ra3xdh/TRX_RA3XDH_v2/README.md

## Описание

Схема и печатная плата для улучшенной версии моего трансивера из журнала Радио №2, 2009.

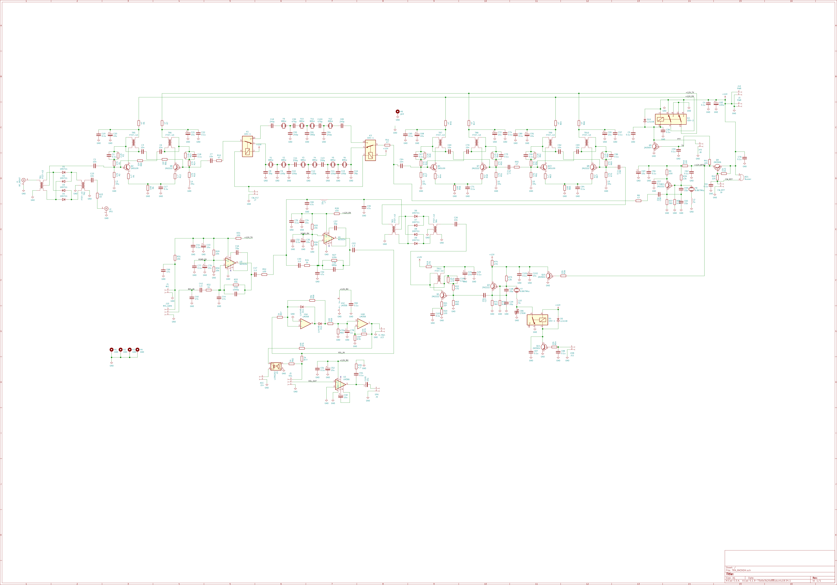
[picture p1: TRX_RA3XDH_v2.png]
Schematic
