ra3xdh/TRX_RA3XDH_v2/ATMega64_AD9850/ATMega64_AD9850.png

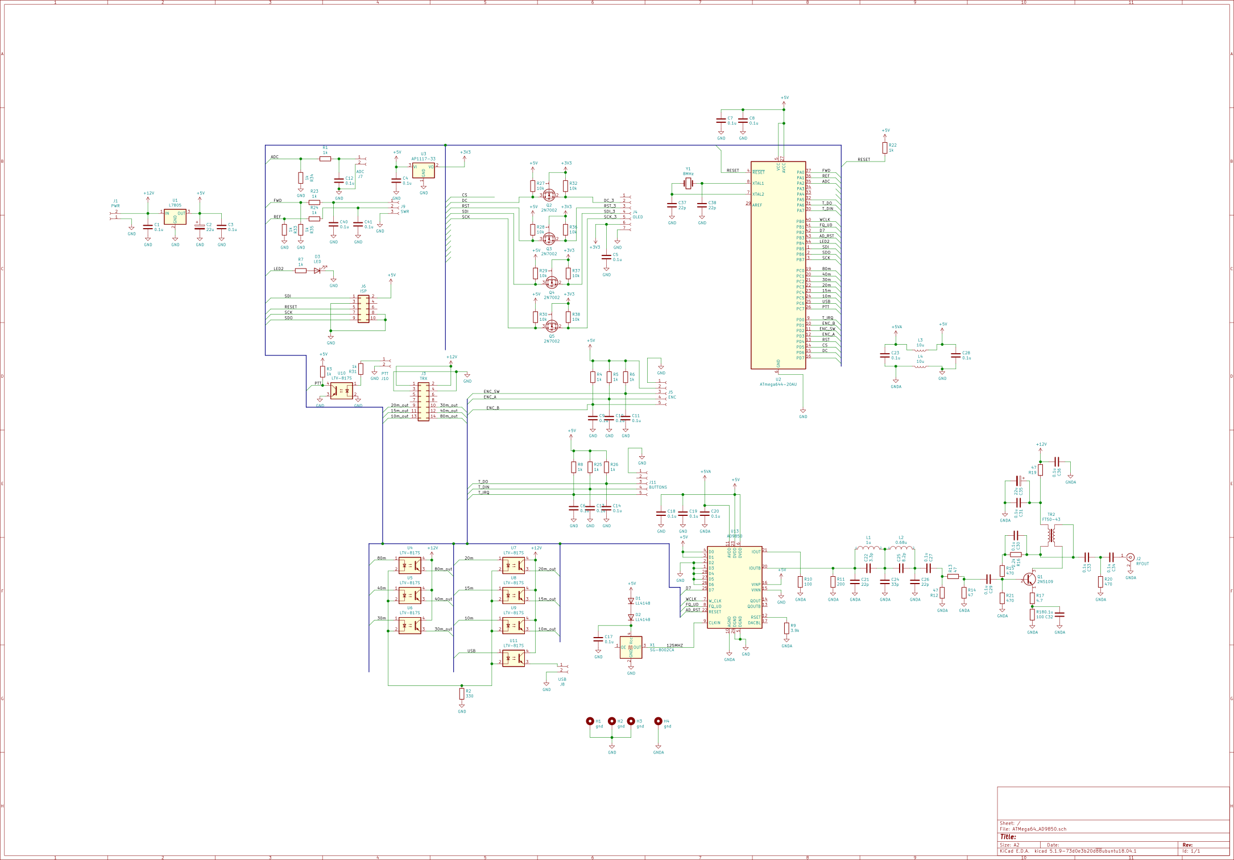
ATMega64_AD9850/ATMega64_AD9850.png
