ra3xdh/TRX_RA3XDH_v2/ATT_and_RF_preamp/ATT_2N5109_AMP.png

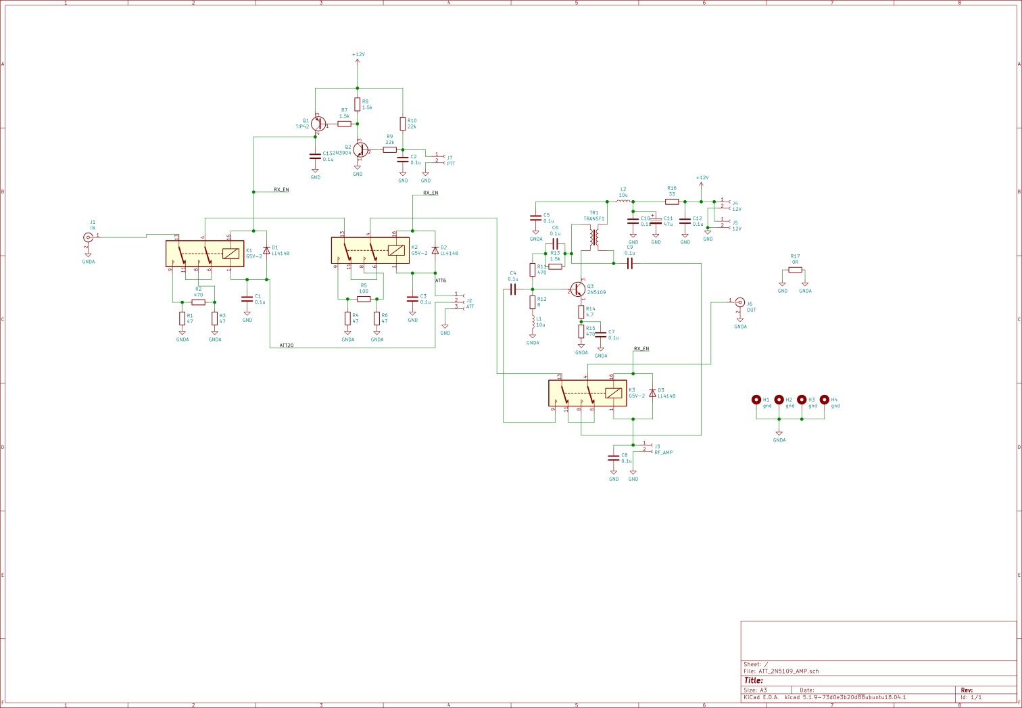
ATT_and_RF_preamp/ATT_2N5109_AMP.png
