ra3xdh/TRX_RA3XDH_v2/BPF_6Band/BPF_6Band.png

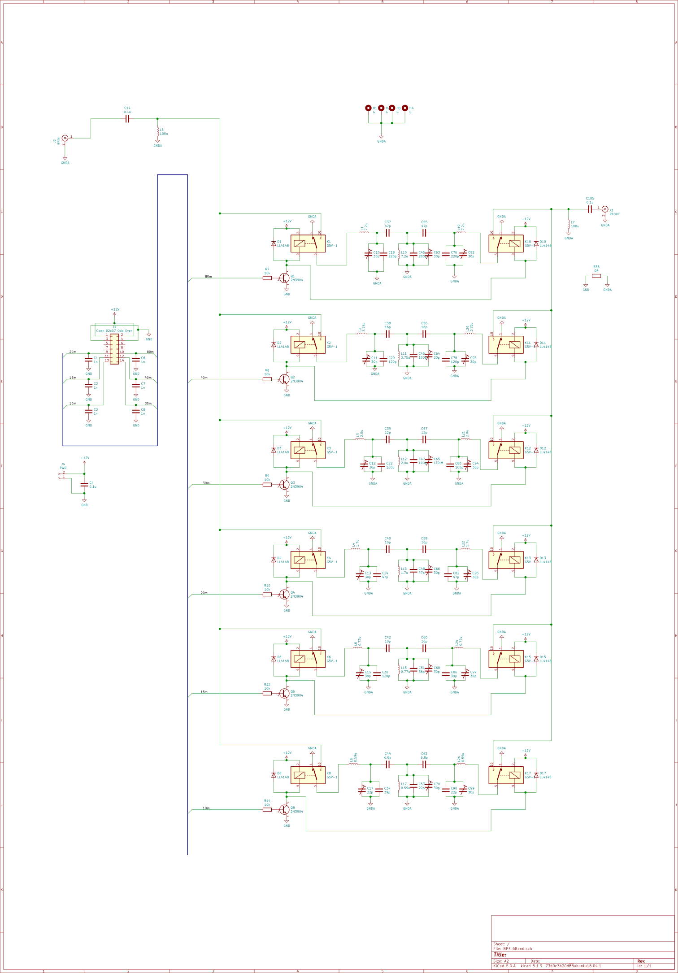
BPF_6Band/BPF_6Band.png
