ra3xdh/TRX_RA3XDH_v2/PA_bypass_and_SWR_mtr/PA_comm.png

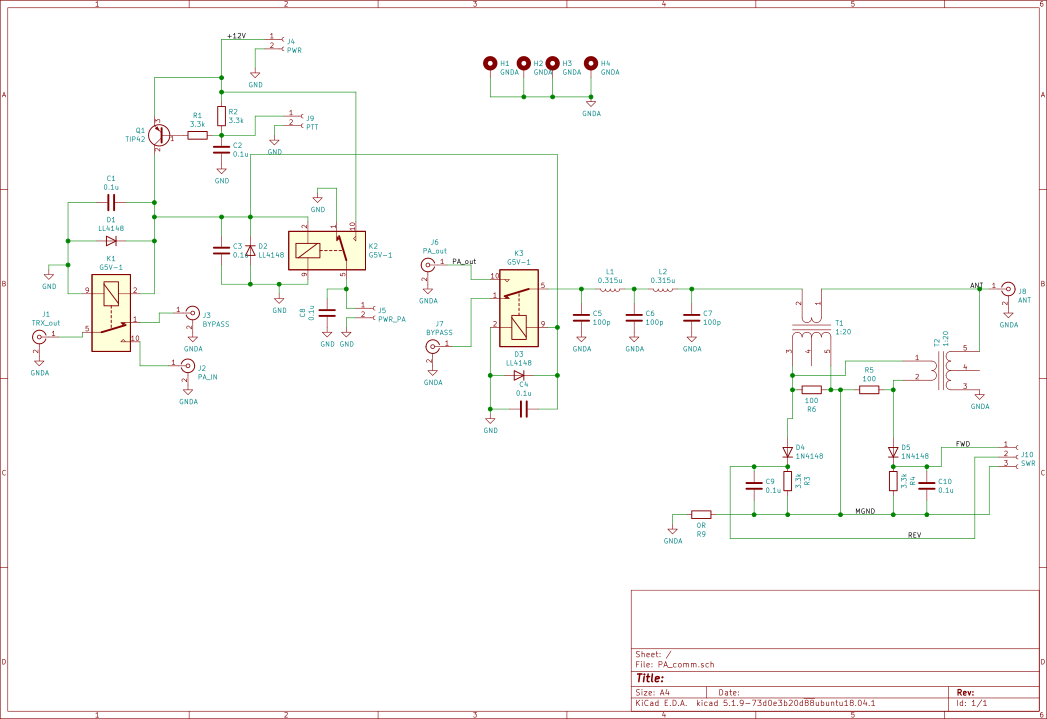
PA_bypass_and_SWR_mtr/PA_comm.png
