ra3xdh/TRX_RA3XDH_v2/ATT_and_RF_preamp/ATT_2N5109_AMP.kicad_pcb

## KiCad design ATT_and_RF_preamp/ATT_2N5109_AMP.kicad_pcb (2021-12-04)

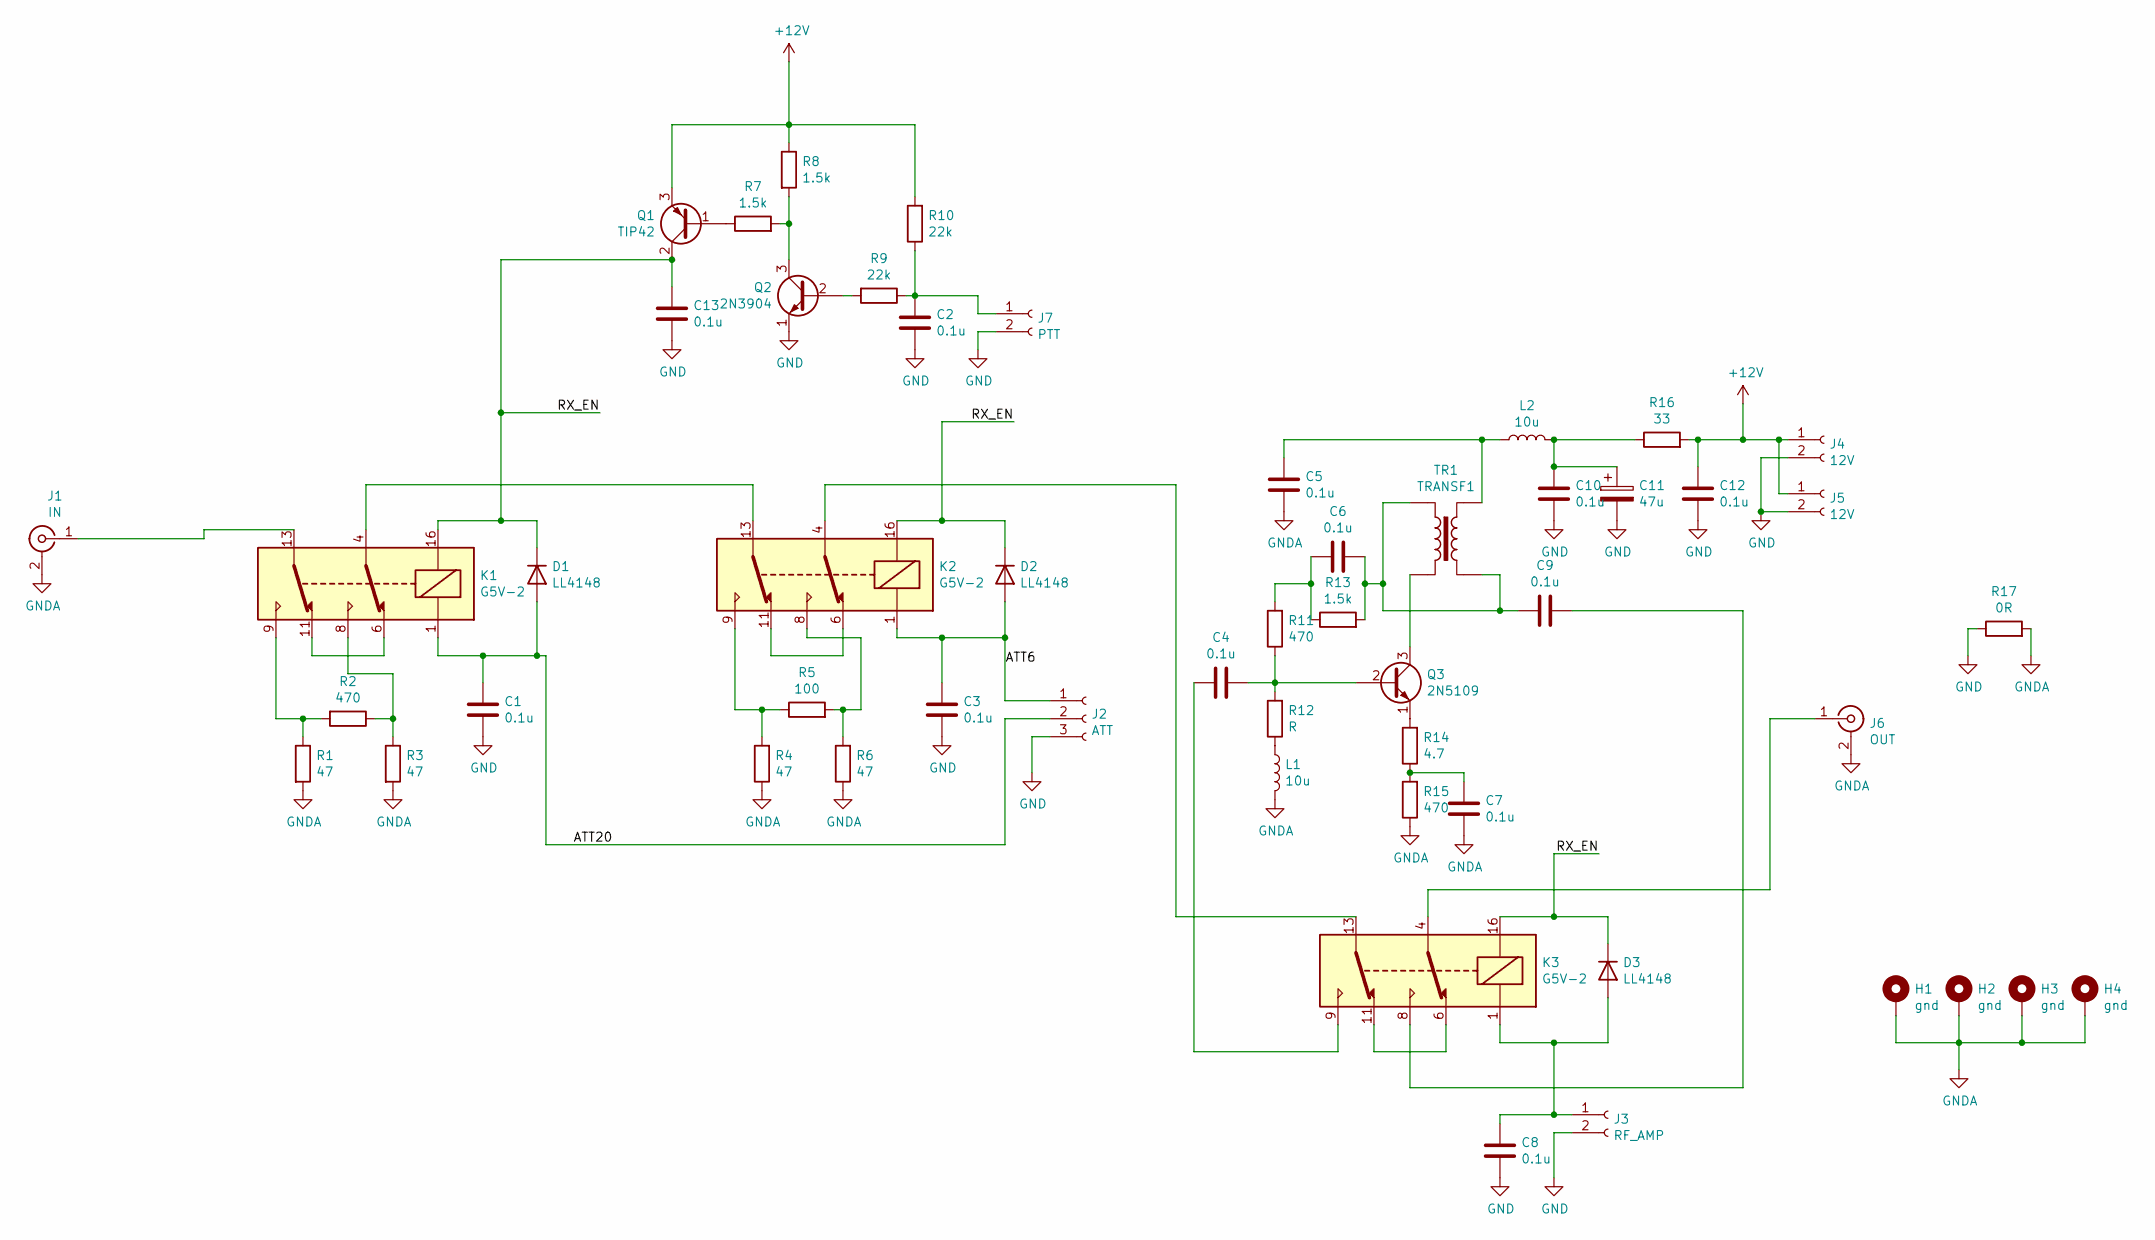
[picture p6: schematic ATT_2N5109_AMP.sch]

Parts:
C1, C2, C3, C4, C5, C6, C7, C8, C9, C10, C12, C13: 0.1u; C_0805_2012Metric_Pad1.18x1.45mm_HandSolder
C11: 47u; CP_Radial_D5.0mm_P2.50mm
D1, D2, D3: LL4148; D_MiniMELF
H1, H2, H3, H4: gnd; MountingHole_3.2mm_M3_ISO14580_Pad
J1: IN; SMA_Amphenol_132134_Vertical
J2: ATT; JST_EH_B3B-EH-A_1x03_P2.50mm_Vertical
J3: RF_AMP; JST_EH_B2B-EH-A_1x02_P2.50mm_Vertical
J4, J5: 12V; JST_EH_B2B-EH-A_1x02_P2.50mm_Vertical
J6: OUT; SMA_Amphenol_132134_Vertical
J7: PTT; JST_EH_B2B-EH-A_1x02_P2.50mm_Vertical
K1, K2, K3: G5V-2; Relay_DPDT_Omron_G5V-2
L1, L2: 10u; L2.5x6
Q1: TIP42; TO-220-3_Vertical
Q2: 2N3904; TO-92_Inline
Q3: 2N5109; TO-5-3
R1, R3, R4, R6: 47; R_0805_2012Metric_Pad1.20x1.40mm_HandSolder
R2, R11, R15: 470; R_0805_2012Metric_Pad1.20x1.40mm_HandSolder
R5: 100; R_0805_2012Metric_Pad1.20x1.40mm_HandSolder
R7, R8, R13: 1.5k; R_0805_2012Metric_Pad1.20x1.40mm_HandSolder
R9, R10: 22k; R_0805_2012Metric_Pad1.20x1.40mm_HandSolder
R12: R; R_0805_2012Metric_Pad1.20x1.40mm_HandSolder
R14: 4.7; R_0805_2012Metric_Pad1.20x1.40mm_HandSolder
R16: 33; R_0805_2012Metric_Pad1.20x1.40mm_HandSolder
R17: 0R; R_0805_2012Metric_Pad1.20x1.40mm_HandSolder
TR1: TRANSF1; L_Toroid_Vertical_L10.0mm_W5.0mm_4pin

Connections:
+12V: C12.1, J4.1, J5.1, Q1.3 (E), R8.1, R10.2, R16.2
/ATT6: C3.1, D2.2 (A), J2.1, K2.1
/ATT20: C1.1, D1.2 (A), J2.2, K1.1
/RX_EN: C13.1, D1.1 (K), D2.1 (K), D3.1 (K), K1.16, K2.16, K3.16, Q1.2 (C)
GND: C1.2, C2.2, C3.2, C8.2, C10.2, C11.2, C12.2, C13.2, J2.3, J3.2, J4.2, J5.2, J7.2, Q2.1 (E), R17.1
GNDA: C5.2, C7.2, H1.1, H2.1, H3.1, H4.1, J1.2 (Ext), J6.2 (Ext), L1.2, R1.2, R3.2, R4.1, R6.1, R15.1, R17.2
unnamed: C2.1, J7.1, R9.1, R10.1
unnamed: C4.1, Q3.2 (B), R11.1, R12.2
unnamed: C4.2, K3.9
unnamed: C5.1, L2.1, TR1.4
unnamed: C6.1, C9.2, R13.2, TR1.1, TR1.3
unnamed: C6.2, R11.2, R13.1
unnamed: C7.1, R14.1, R15.2
unnamed: C8.1, D3.2 (A), J3.1, K3.1
unnamed: C9.1, K3.8
unnamed: C10.1, C11.1, L2.2, R16.1
unnamed: J1.1 (In), K1.13
unnamed: J6.1 (In), K3.4
unnamed: K1.4, K2.13
unnamed: K1.8, R2.1, R3.1
unnamed: K1.9, R1.1, R2.2
unnamed: K1.6, K1.11
unnamed: K2.4, K3.13
unnamed: K2.8, R5.2, R6.2
unnamed: K2.9, R4.2, R5.1
unnamed: K2.6, K2.11
unnamed: K3.6, K3.11
unnamed: L1.1, R12.1
unnamed: Q1.1 (B), R7.1
unnamed: Q2.2 (B), R9.2
unnamed: Q2.3 (C), R7.2, R8.2
unnamed: Q3.1 (E), R14.2
unnamed: Q3.3 (C), TR1.2

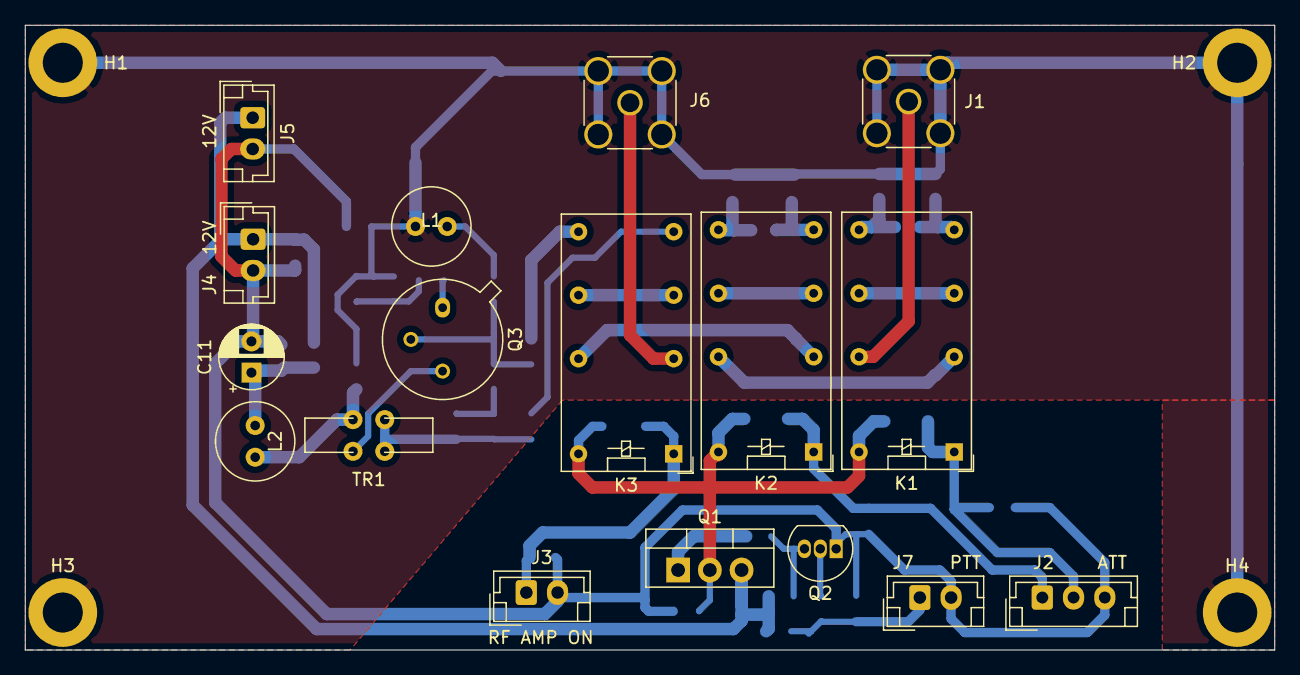
[picture p7: board ATT_2N5109_AMP.kicad_pcb from above]

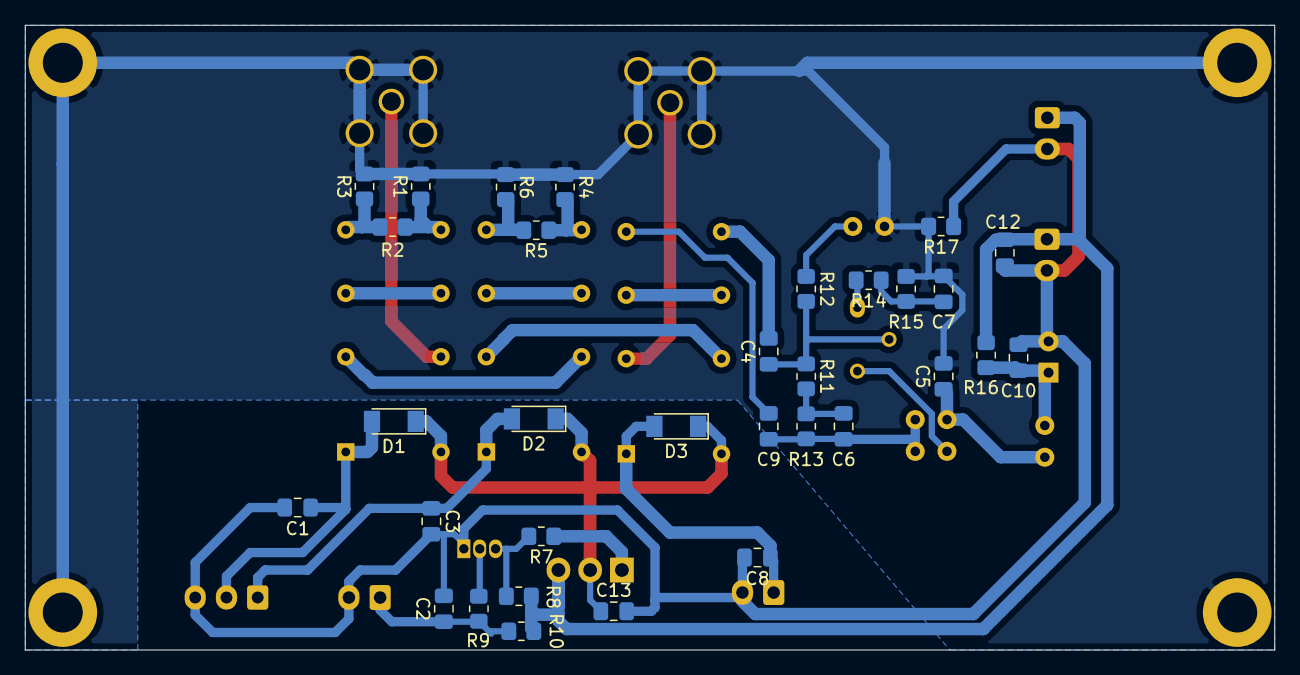
[picture p8: board ATT_2N5109_AMP.kicad_pcb from below]

Board: 2 copper layers, 100.0 x 50.0 mm, 53 parts (32 on the bottom side), 33 nets.
