ra3xdh/TRX_RA3XDH_v2/PA_bypass_and_SWR_mtr/PA_comm.kicad_pcb

## KiCad design PA_bypass_and_SWR_mtr/PA_comm.kicad_pcb (2021-12-04)

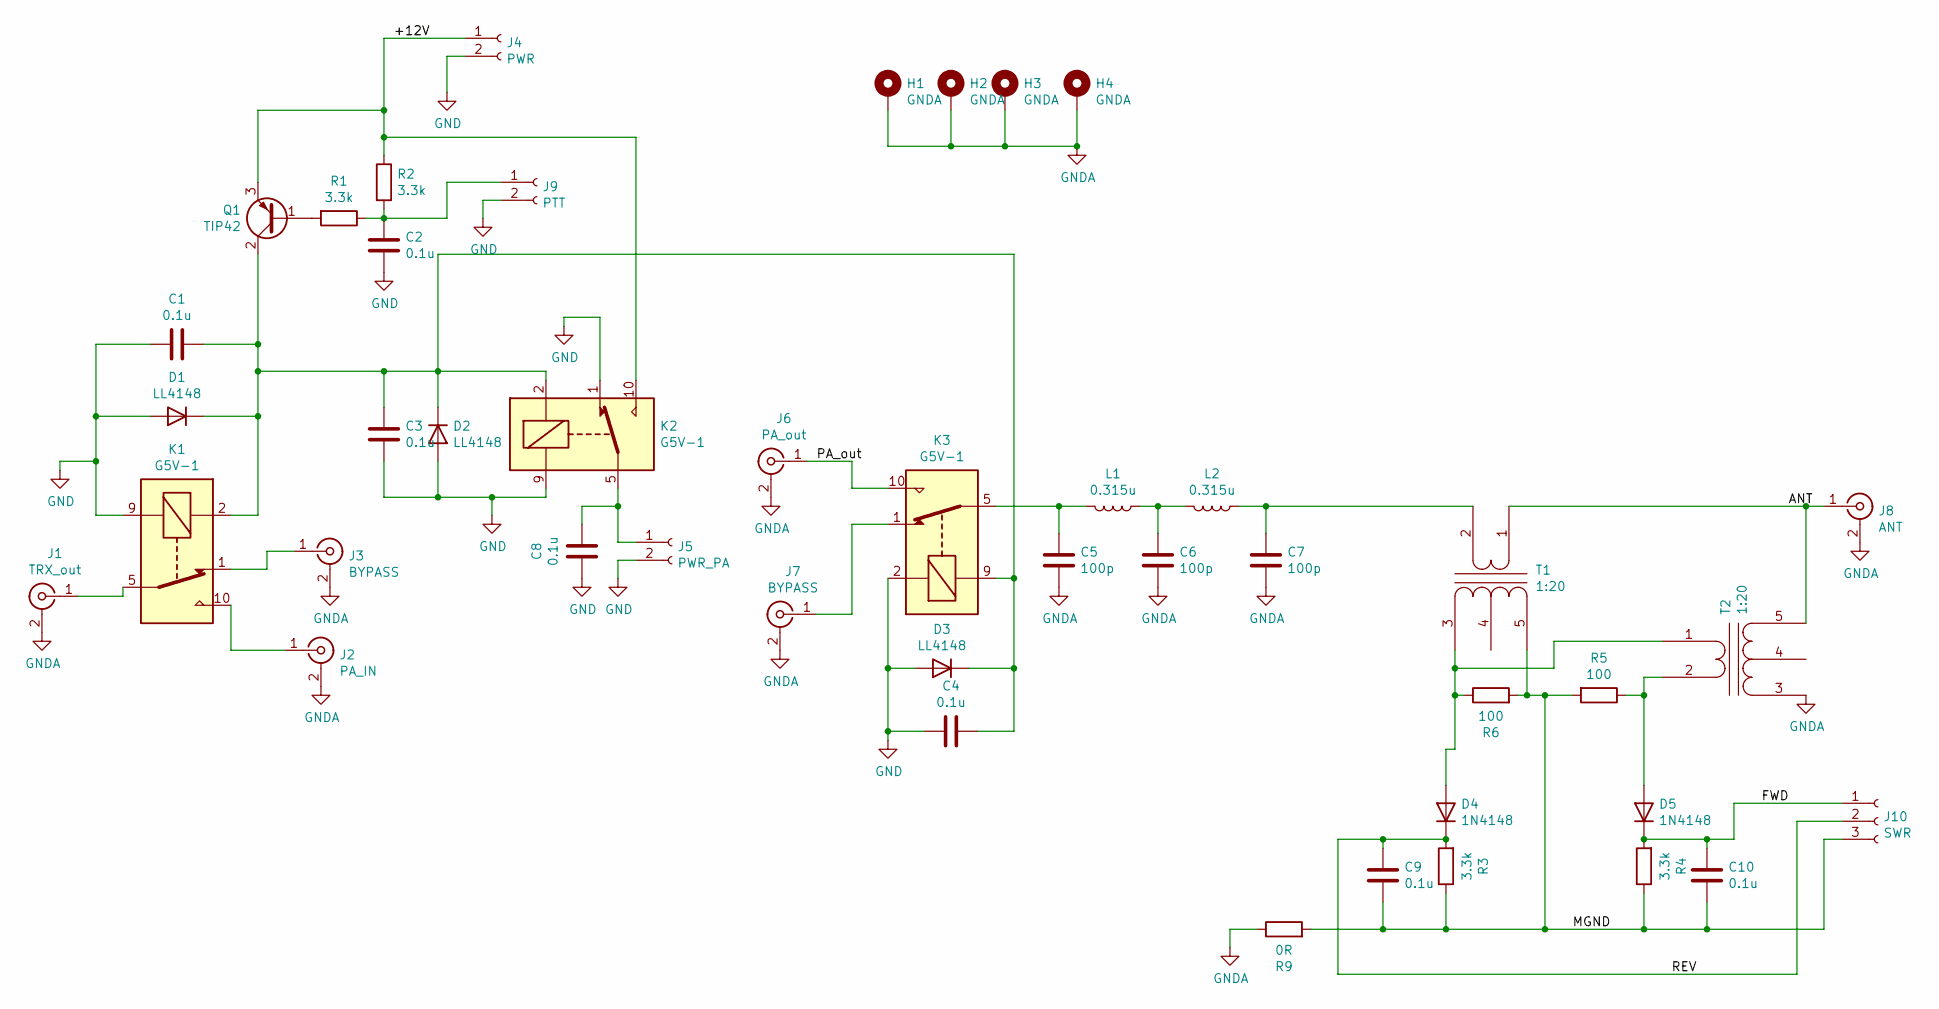
[picture p9: schematic PA_comm.sch]

Parts:
C1, C2, C3, C4, C8, C9, C10: 0.1u; C_0805_2012Metric
C5, C6, C7: 100p; C_Disc_D4.3mm_W1.9mm_P5.00mm
D1, D2, D3: LL4148; D_MiniMELF
D4, D5: 1N4148; D_DO-35_SOD27_P7.62mm_Horizontal
H1, H2, H3, H4: GNDA; MountingHole_3.2mm_M3_DIN965_Pad
J1: TRX_out; SMA_Amphenol_901-144_Vertical
J2: PA_IN; SMA_Amphenol_901-144_Vertical
J3, J7: BYPASS; SMA_Amphenol_901-144_Vertical
J4: PWR; JST_EH_B2B-EH-A_1x02_P2.50mm_Vertical
J5: PWR_PA; JST_EH_B2B-EH-A_1x02_P2.50mm_Vertical
J6: PA_out; SMA_Amphenol_901-144_Vertical
J8: ANT; SMA_Amphenol_901-144_Vertical
J9: PTT; JST_EH_B2B-EH-A_1x02_P2.50mm_Vertical
J10: SWR; JST_EH_B3B-EH-A_1x03_P2.50mm_Vertical
K1, K2, K3: G5V-1; Relay_SPDT_Omron_G5V-1
L1, L2: 0.315u; L_Toroid_Vertical_L10.0mm_W5.0mm_P5.08mm
Q1: TIP42; TO-220-3_Vertical
R1, R2, R3, R4: 3.3k; R_0805_2012Metric
R5, R6: 100; R_0805_2012Metric
R9: 0R; R_0805_2012Metric
T1, T2: 1:20; Current_transf_toroid_5x10mm

Connections:
/+12V: J4.1, K2.10, Q1.3 (E), R2.1
/ANT: J8.1 (In), T1.1 (AA), T2.5 (SB)
/FWD: C10.1, D5.1 (K), J10.1, R4.2
/MGND: C9.2, C10.2, J10.3, R3.1, R4.1, R5.2, R6.2, R9.2, T1.5 (SB)
/PA_out: J6.1 (In), K3.10
/REV: C9.1, D4.1 (K), J10.2, R3.2
GND: C1.2, C2.2, C3.2, C4.1, C8.1, D1.2 (A), D2.2 (A), D3.2 (A), J4.2, J5.2, J9.2, K1.9, K2.1, K2.9, K3.2
GNDA: C5.2, C6.2, C7.2, H1.1, H2.1, H3.1, H4.1, J1.2 (Ext), J2.2 (Ext), J3.2 (Ext), J6.2 (Ext), J7.2 (Ext), J8.2 (Ext), R9.1, T2.3 (SA)
unnamed: C1.1, C3.1, C4.2, D1.1 (K), D2.1 (K), D3.1 (K), K1.2, K2.2, K3.9, Q1.2 (C)
unnamed: C2.1, J9.1, R1.1, R2.2
unnamed: C5.1, K3.5, K3.6, L1.2
unnamed: C6.1, L1.1, L2.2
unnamed: C7.1, L2.1, T1.2 (AB)
unnamed: C8.2, J5.1, K2.5, K2.6
unnamed: D4.2 (A), R6.1, T1.3 (SA), T2.1 (AA)
unnamed: D5.2 (A), R5.1, T2.2 (AB)
unnamed: J1.1 (In), K1.5, K1.6
unnamed: J2.1 (In), K1.10
unnamed: J3.1 (In), K1.1
unnamed: J7.1 (In), K3.1
unnamed: Q1.1 (B), R1.2

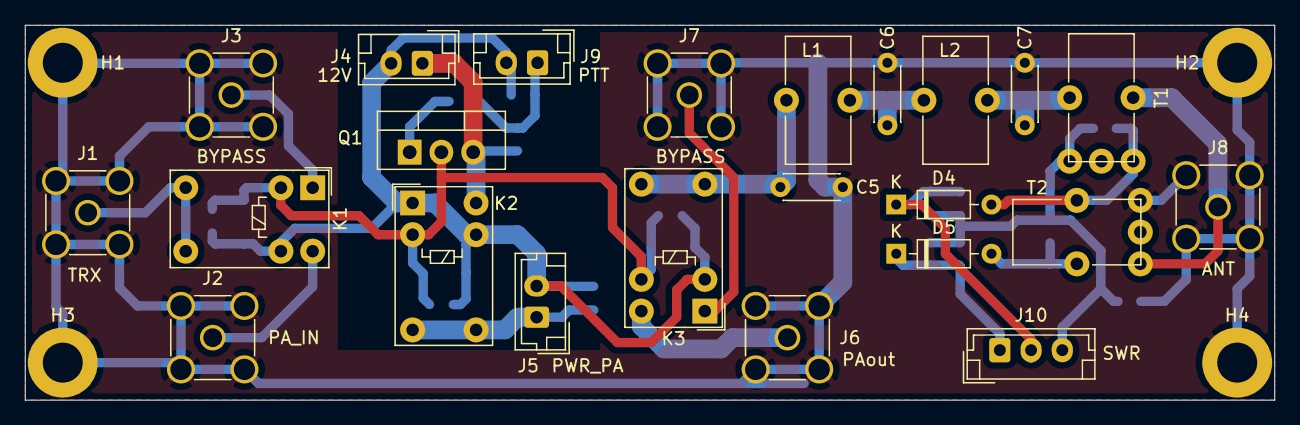
[picture p10: board PA_comm.kicad_pcb from above]

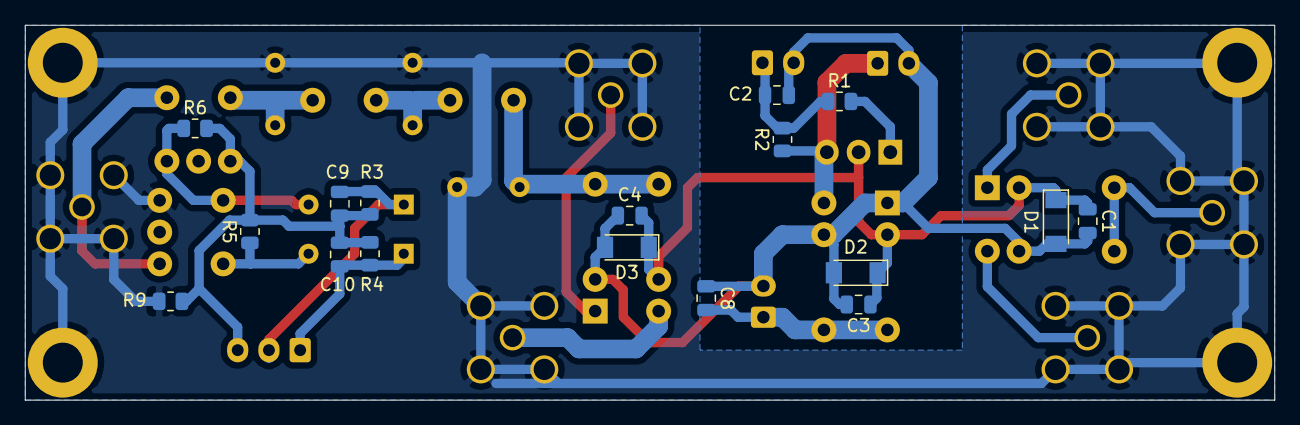
[picture p11: board PA_comm.kicad_pcb from below]

Board: 2 copper layers, 100.0 x 30.0 mm, 44 parts (17 on the bottom side), 21 nets.
