ra3xdh/TRX_RA3XDH_v2/Mainboard/TRX_RA3XDH.kicad_pcb

## KiCad design Mainboard/TRX_RA3XDH.kicad_pcb (2021-12-04)

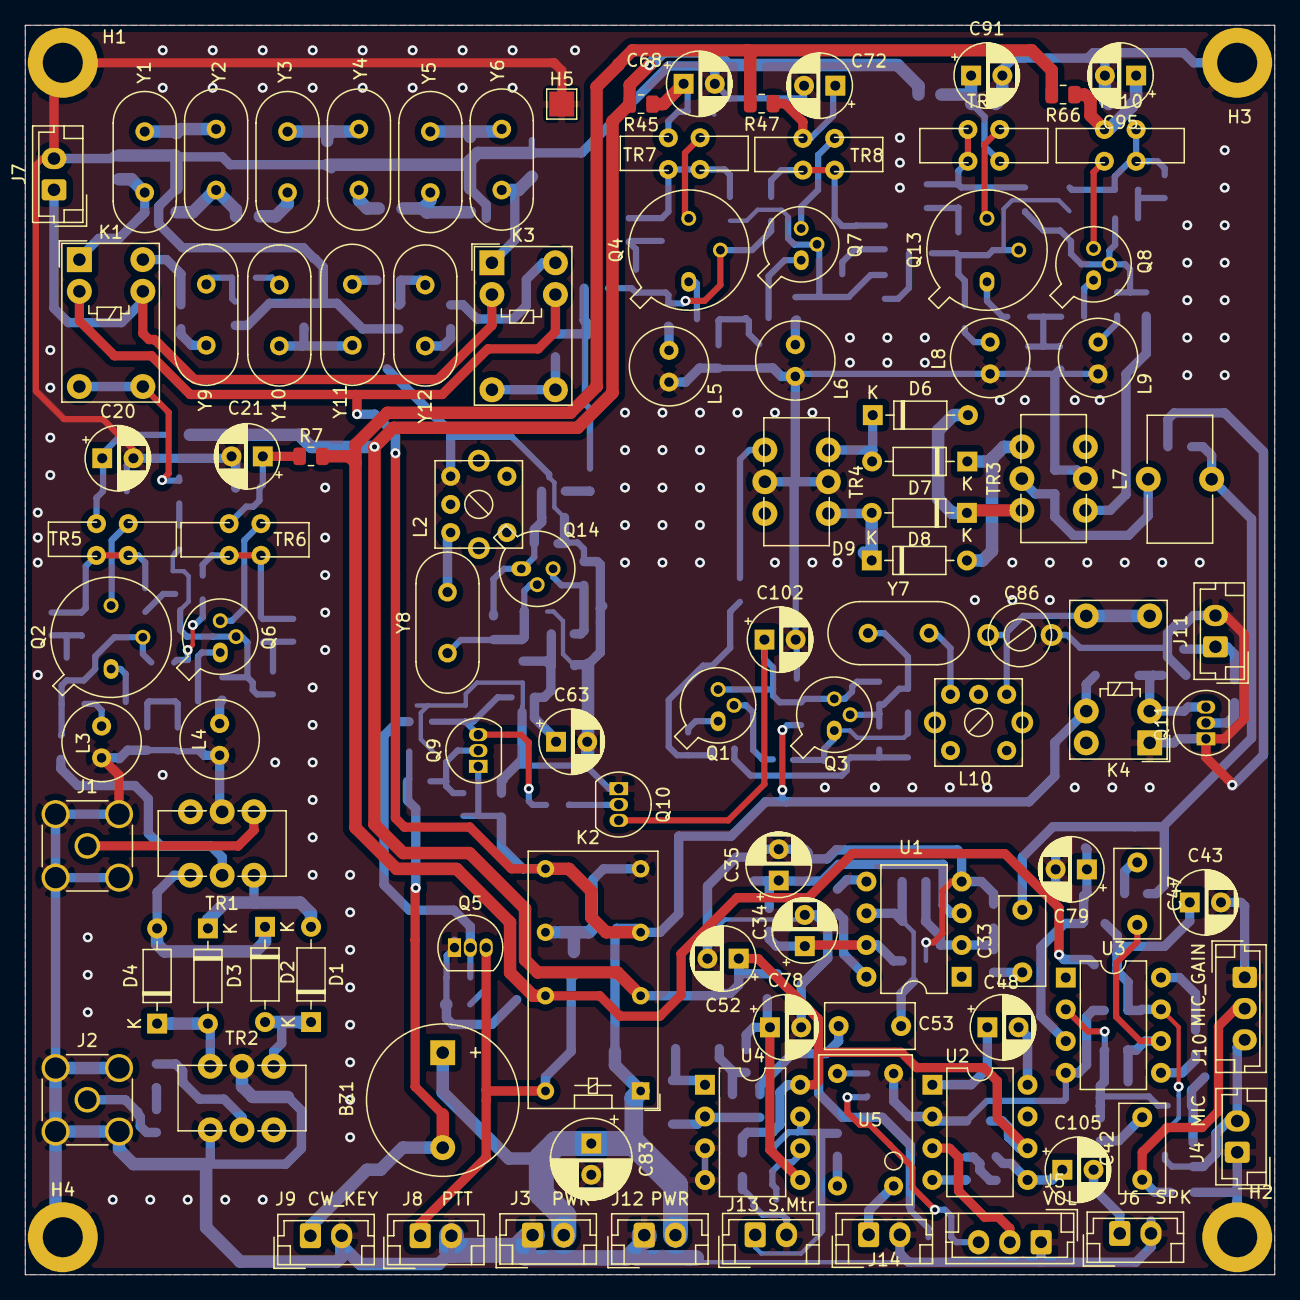
[picture p12: board TRX_RA3XDH.kicad_pcb from above]

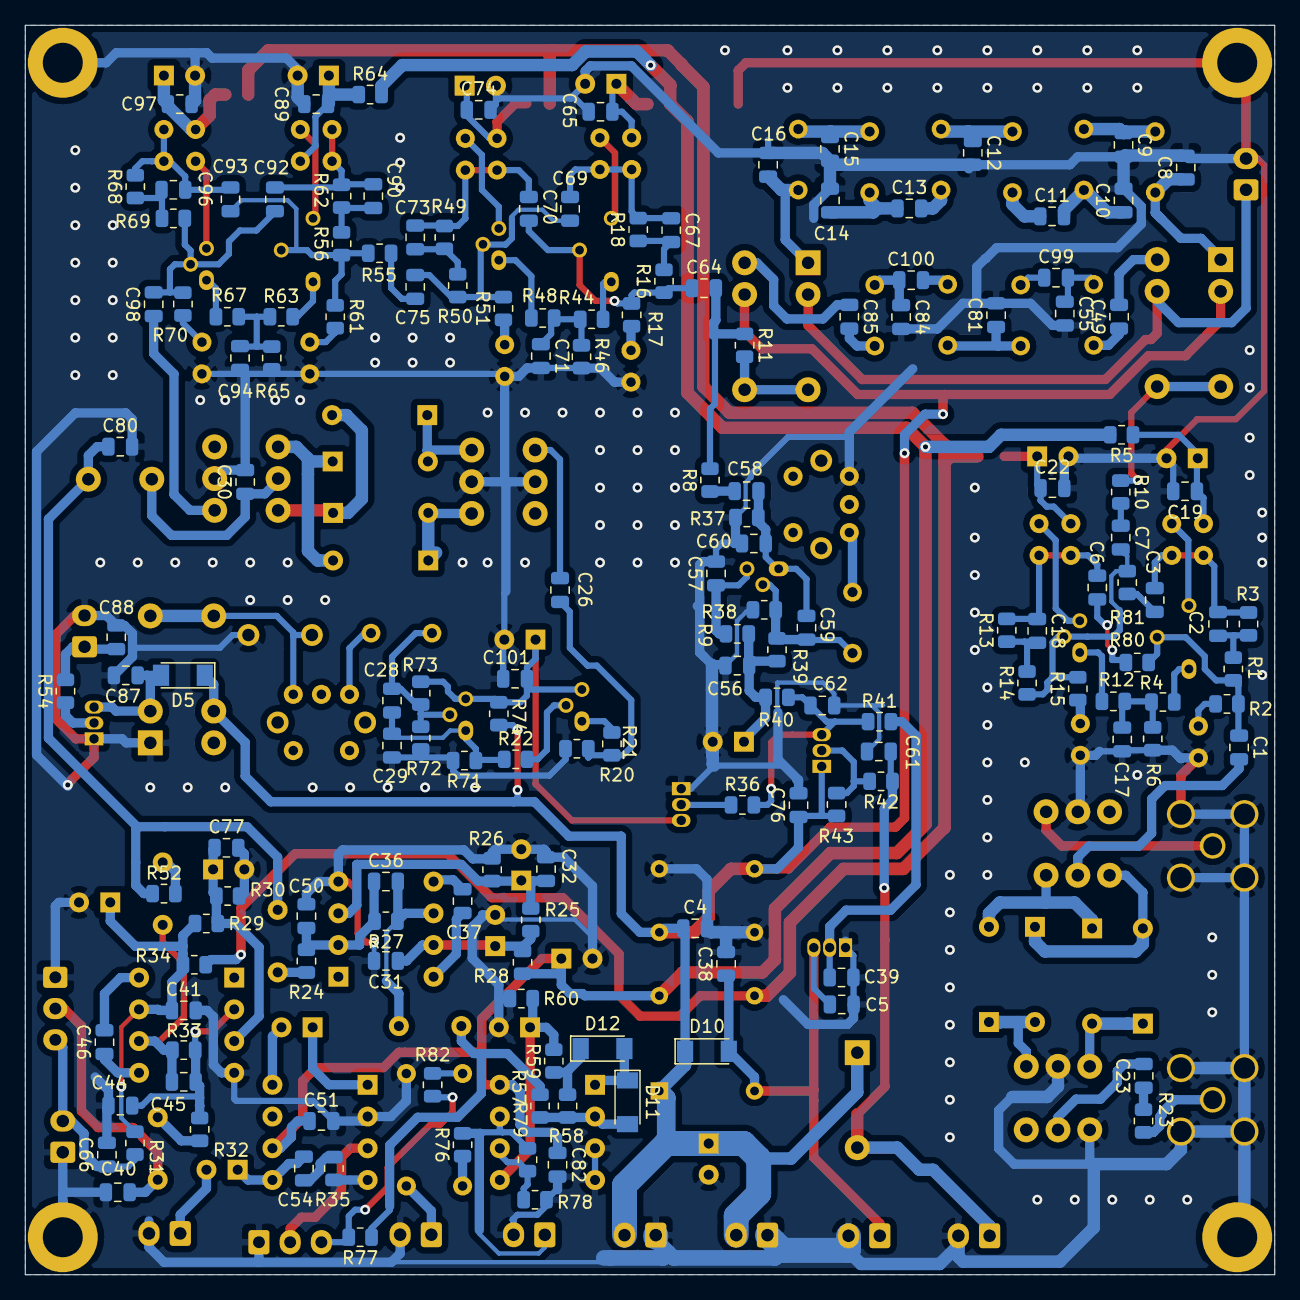
[picture p13: board TRX_RA3XDH.kicad_pcb from below]

Board: 2 copper layers, 100.0 x 100.0 mm, 264 parts (157 on the bottom side), 149 nets.

Parts:
BZ1: Buzzer; Buzzer_12x9.5RM7.6
C1, C3, C6, C7, C23, C26, C64, C69, C70, C92, C93: 10n; C_0805_2012Metric
C2, C4, C5, C17, C18, C19, C22, C31, C32, C38, C39, C41, C51, C54, C56, C57, C61, C62, C65, C67, C71, C73, C74, C75, C76, C77, C82, C87, C88, C89, C90, C94, C96, C97, C98, C101: 0.1u; C_0805_2012Metric
C8, C16: 39p; C_0805_2012Metric
C9, C10, C14, C15: 100p; C_0805_2012Metric
C11, C13: 330p; C_0805_2012Metric
C12: 120p; C_0805_2012Metric
C20, C21, C34, C35, C43, C48, C52, C63, C68, C72, C79, C91, C95, C102, C105: 10u; CP_Radial_D5.0mm_P2.50mm
C28, C29, C58, C59, C60: 22p; C_0805_2012Metric
C30, C40, C44, C50, C66, C80: 47n; C_0805_2012Metric
C33, C42, C47, C53: 1.0; C_Rect_L7.0mm_W3.5mm_P5.00mm
C36: 680p; C_0805_2012Metric
C37, C46: 33p; C_0805_2012Metric
C45: 1000p; C_0805_2012Metric
C49, C55, C84, C85: 240p; C_0805_2012Metric
C78: 1u; CP_Radial_D5.0mm_P2.50mm
C81: 390p; C_0805_2012Metric
C83: 100u; CP_Radial_D6.3mm_P2.50mm
C86: CTRIM; Ctrimm_5mm
C99, C100: 470p; C_0805_2012Metric
D1, D2, D3, D4, D6, D7, D8, D9: 1N5711; D_DO-35_SOD27_P7.62mm_Horizontal
D5, D10, D11, D12: LL4148; D_MiniMELF
H1, H2, H3, H4: GND; MountingHole_3.2mm_M3_DIN965_Pad
H5: gnd; TestPoint_Pad_2.0x2.0mm
J1: RF_INOUT; SMA_Amphenol_132291_Vertical
J2: VFO; SMA_Amphenol_132291_Vertical
J3, J12: PWR; JST_EH_B2B-EH-A_1x02_P2.50mm_Vertical
J4: MIC; JST_EH_B2B-EH-A_1x02_P2.50mm_Vertical
J5: VOL; JST_EH_B3B-EH-A_1x03_P2.50mm_Vertical
J6: SPK; JST_EH_B2B-EH-A_1x02_P2.50mm_Vertical
J7: CW_FLT; JST_EH_B2B-EH-A_1x02_P2.50mm_Vertical
J8: PTT; JST_EH_B2B-EH-A_1x02_P2.50mm_Vertical
J9: CW_KEY; JST_EH_B2B-EH-A_1x02_P2.50mm_Vertical
J10: MIC_GAIN; JST_EH_B3B-EH-A_1x03_P2.50mm_Vertical
J11: USB; JST_EH_B2B-EH-A_1x02_P2.50mm_Vertical
J13: S-Met.; JST_EH_B2B-EH-A_1x02_P2.50mm_Vertical
J14: AGC; JST_EH_B2B-EH-A_1x02_P2.50mm_Vertical
K1, K3, K4: G5V-1; Relay_SPDT_Omron_G5V-1
K2: G5V-2; Relay_DPDT_Omron_G5V-2
L2, L10: 3u; NEOSID_5t_4.5x4.5mm_132
L3, L4, L5, L6, L8, L9: 33u; L2.5x6
L7: 33u; L_Toroid_Vertical_L10.0mm_W5.0mm_P5.08mm
Q1, Q3, Q6, Q7, Q8, Q14: 2N2222; TO-18-3
Q2, Q4, Q13: 2N5109; TO-5-3
Q5, Q10, Q11: 2N3904; TO-92_Inline
Q9: 2N3906; TO-92_Inline
R1, R2, R14, R15, R16, R17, R51, R56, R61, R70: 470; R_0805_2012Metric
R3, R13, R18, R49, R62, R68: 2.2k; R_0805_2012Metric
R4, R12, R35, R44, R63: 4.7; R_0805_2012Metric
R5, R7, R8, R10, R11, R45, R47, R55, R64, R66: 47; R_0805_2012Metric
R6, R9, R20, R28, R34, R40, R46, R52, R59, R65, R74, R76: 100; R_0805_2012Metric
R21, R80, R81: 33*; R_0805_2012Metric
R22: 1.5k; R_0805_2012Metric
R23: 33; R_0805_2012Metric
R24, R32, R57, R82: 1k; R_0805_2012Metric
R25, R26, R29, R30, R31: 20k; R_0805_2012Metric
R27: 120k; R_0805_2012Metric
R33, R58: 33k; R_0805_2012Metric
R36, R41, R42, R43, R54: 22k; R_0805_2012Metric
R37, R71: 360; R_0805_2012Metric
R38, R72: 6.8k; R_0805_2012Metric
R39, R73: 13k; R_0805_2012Metric
R48, R67: 8.2; R_0805_2012Metric
R50, R69: 270; R_0805_2012Metric
R60: 470k; R_0805_2012Metric
R77: 2k; R_0805_2012Metric
R78: 10k*; R_0805_2012Metric
R79: 10k; R_0805_2012Metric
TR1, TR2, TR3, TR4: FT37-43; L_Toroid_Vertical_L10.0mm_W5.0mm_6pin
TR5, TR6, TR7, TR8, TR9, TR10: FT37-43; L_Toroid_Vertical_L10.0mm_W5.0mm_4pin
U1, U3: NE5534; DIP-8_W7.62mm
U2: LM386; DIP-8_W7.62mm
U4: LM358; DIP-8_W7.62mm
U5: LCR0202; lcr0202
Y1, Y2, Y3, Y4, Y5, Y6, Y9, Y10, Y11, Y12: 8Mhz; Crystal_HC49-U_Vertical
Y7, Y8: 8.867Mhz; Crystal_HC49-U_Vertical

Connections:
+12V: BZ1.1, C4.1, C76.1, C83.1, D5.1, D10.1, J3.2, J12.2, K1.2, K2.1, K2.6, K2.9, K3.9, K4.9, Q9.1, R43.2, R74.1
/+12V_BFO2: C62.1, Q9.3, R36.2, R40.2, R41.1
/+12V_RX: C51.1, C52.1, C82.1, K2.4, R5.2, R28.1, R45.2, R64.2, U2.6, U4.8
/+12V_TX: K2.13, R7.2, R34.1, R47.2, R66.2
/CW_KEY: BZ1.2, C61.1, J9.1, R42.1
/MIC_IN: C40.1, C42.2, J10.2
/PTT: C5.1, C38.1, D10.2, J8.1, K2.16, Q5.3
/TX: C39.1, Q5.2, R41.2
/VGND_RX: C32.1, C35.1, R25.2, R26.1, U1.3
/VGND_TX: C77.1, C79.1, R29.2, R30.1, U3.3
/VOL_IN: C53.1, R57.1, R77.1
/VOL_OUT: J5.2, U2.3
GND: C4.2, C5.2, C8.2, C9.2, C10.2, C12.2, C14.2, C15.2, C16.2, C17.2, C19.2, C20.2, C21.2, C22.2, C29.2, C30.2, C31.2, C32.2, C34.2, C35.2, C38.2, C39.2, C40.2, C41.2, C43.2, C44.2, C50.2, C51.2, C52.2, C55.2, C56.2, C57.2, C60.2, C61.2, C62.2, C63.2, C65.2, C66.2, C68.2, C71.2, C72.2, C74.2, C76.2, C77.2, C78.2, C79.2, C80.2, C81.2, C82.2, C83.2, C84.2, C86.2, C87.2, C88.2, C89.2, C91.2, C94.2, C95.2, C97.2, C101.2, C102.2, H1.1, H2.1, H3.1, H4.1, H5.1, J1.2, J2.2, J3.1, J4.1, J5.1, J6.2, J7.2, J8.2, J9.2, J10.1, J11.2, J12.1, J13.2, J14.2, K2.8, K2.11, K4.1, L2.2, L3.2, L4.2, L5.2, L6.2, L8.2, L9.2, Q5.1, Q10.1, Q11.1, R6.1, R20.2, R26.2, R30.2, R35.1, R37.2, R38.2, R46.1, R60.2, R65.1, R71.2, R72.2, R78.2, TR1.5, TR2.2, TR2.4, TR3.5, TR4.2, TR4.5, U1.4, U2.2, U2.4, U3.4, U4.3, U4.4, U5.3
unnamed: C1.1, Q2.2, R1.1, R2.2, R80.2
unnamed: C1.2, TR1.2
unnamed: C2.1, C3.2, R3.2, TR5.1, TR5.3
unnamed: C2.2, R1.2, R3.1
unnamed: C3.1, R81.2
unnamed: C6.2, R80.1
unnamed: C7.1, R10.2
unnamed: C7.2, Q6.2, R14.1, R15.2, R81.1
unnamed: C8.1, K1.1, Y1.1
unnamed: C9.1, Y1.2, Y2.1
unnamed: C10.1, C11.2, Y2.2
unnamed: C11.1, Y3.1
unnamed: C12.1, Y3.2, Y4.1
unnamed: C13.1, C14.1, Y5.1
unnamed: C13.2, Y4.2
unnamed: C15.1, Y5.2, Y6.1
unnamed: C16.1, K3.1, Y6.2
unnamed: C17.1, R4.1, R6.2, R12.1
unnamed: C6.1, C18.1, R13.2, TR6.2, TR6.4
unnamed: C18.2, R13.1, R14.2
unnamed: C19.1, C20.1, R5.1, TR5.4
unnamed: C21.1, C22.1, R7.1, TR6.1
unnamed: C23.1, R23.1
unnamed: C23.2, TR2.5
unnamed: C26.1, R20.1, R21.2
unnamed: C26.2, TR4.4
unnamed: C28.1, Q3.2, R72.1, R73.2, Y7.1
unnamed: C28.2, C29.1, Q3.1, R22.1, R71.1
unnamed: C30.1, L7.1, TR3.2
unnamed: C31.1, C34.1, R25.1, R28.2, U1.7
unnamed: C33.1, R24.2
unnamed: C33.2, C80.1, L7.2, R52.1
unnamed: C36.1, C50.1, R24.1, R27.2, U1.2
unnamed: C36.2, C53.2, R27.1, U1.6
unnamed: C37.1, U1.5
unnamed: C37.2, U1.8
unnamed: C41.1, C43.1, R29.1, R31.1, R34.2, U3.7
unnamed: C42.1, R32.2
unnamed: C44.1, C45.1, R32.1, R33.2, U3.2
unnamed: C45.2, C47.2, R33.1, U3.6
unnamed: C46.1, U3.5
unnamed: C46.2, U3.8
unnamed: C47.1, R52.2
unnamed: C48.1, U2.1
unnamed: C48.2, U2.8
unnamed: C49.1, Y9.1
unnamed: C49.2, K1.10
unnamed: C54.1, R35.2
unnamed: C55.1, C99.2, Y9.2
unnamed: C56.1, C63.1, R9.1, R39.1, R40.1
unnamed: C57.1, Q14.3, R9.2
unnamed: C58.1, C59.2, C60.1, Q14.1, R37.1
unnamed: C58.2, R8.1
unnamed: C59.1, Q14.2, R38.1, R39.2, Y8.1
unnamed: C64.1, C70.2, Q4.2, R16.1, R17.2
unnamed: C64.2, R8.2, R11.1
unnamed: C65.1, C68.1, R45.1, TR7.4
unnamed: C66.1, J4.2, J10.3, R31.2
unnamed: C67.1, C69.2, R18.2, TR7.1, TR7.3
unnamed: C67.2, R16.2, R18.1
unnamed: C69.1, C75.2, Q7.2, R50.1, R51.2
unnamed: C70.1, C73.1, R49.2, TR8.2, TR8.4
unnamed: C71.1, R44.1, R46.2, R48.1
unnamed: C72.1, C74.1, R47.1, TR8.1
unnamed: C73.2, R49.1, R50.2
unnamed: C75.1, R55.2
unnamed: C78.1, R59.2, R60.1, U4.5
unnamed: C81.1, Y10.2, Y11.1
unnamed: C85.1, K3.10
unnamed: C85.2, Y12.2
unnamed: C86.1, K4.5, K4.6, L10.2
unnamed: C87.1, D5.2, K4.2, Q11.3
unnamed: C88.1, J11.1, R54.2
unnamed: C89.1, C91.1, R64.1, TR9.4
unnamed: C90.1, C92.2, R62.2, TR9.1, TR9.3
unnamed: C90.2, R56.2, R62.1
unnamed: C92.1, C98.2, Q8.2, R69.1, R70.2
unnamed: C93.1, C96.1, R68.2, TR10.2, TR10.4
unnamed: C93.2, Q13.2, R55.1, R56.1, R61.2
unnamed: C94.1, R63.1, R65.2, R67.1
unnamed: C95.1, C97.1, R66.1, TR10.1
unnamed: C96.2, R68.1, R69.2
unnamed: C98.1, TR3.4
unnamed: C99.1, Y10.1
unnamed: C84.1, C100.1, Y12.1
unnamed: C100.2, Y11.2
unnamed: C101.1, C102.1, Q1.3, Q3.3, Q10.3, R73.1, R74.2
unnamed: C54.2, C105.1, U2.5
unnamed: C105.2, J6.1
unnamed: D1.1, D2.2, TR2.1
unnamed: D1.2, D3.1, TR1.3
unnamed: D2.1, D4.2, TR1.1
unnamed: D3.2, D4.1, TR2.3
unnamed: D6.1, D7.2, TR4.3
unnamed: D6.2, D8.1, TR3.3
unnamed: D7.1, D9.2, TR3.1
unnamed: D8.2, D9.1, TR4.1
unnamed: D11.1, D12.2, U4.1
unnamed: D11.2, R57.2, R58.1, U4.2
unnamed: D12.1, R58.2, R59.1
unnamed: J1.1, TR1.4
unnamed: J2.1, R23.2
unnamed: J5.3, R77.2, R82.2
unnamed: J7.1, K1.9, K3.2
unnamed: J13.1, R76.2, R79.2, U4.7
unnamed: J14.1, U5.2
unnamed: K1.5, K1.6, R10.1
unnamed: K3.5, K3.6, R11.2
unnamed: L2.1, Y8.2
unnamed: L3.1, R2.1
unnamed: L4.1, R15.1
unnamed: L5.1, R17.1
unnamed: L6.1, R51.1
unnamed: L8.1, R61.1
unnamed: L9.1, R70.1
unnamed: L10.1, Y7.2
unnamed: Q1.1, R21.1
unnamed: Q1.2, R22.2
unnamed: Q2.1, R4.2
unnamed: Q2.3, TR5.2
unnamed: Q4.1, R44.2
unnamed: Q4.3, TR7.2
unnamed: Q6.1, R12.2
unnamed: Q6.3, TR6.3
unnamed: Q7.1, R48.2
unnamed: Q7.3, TR8.3
unnamed: Q8.1, R67.2
unnamed: Q8.3, TR10.3
unnamed: Q9.2, R42.2, R43.1
unnamed: Q10.2, R36.1
unnamed: Q11.2, R54.1
unnamed: Q13.1, R63.2
unnamed: Q13.3, TR9.2
unnamed: R76.1, U5.1
unnamed: R78.1, R79.1, U4.6
unnamed: R82.1, U5.4
