ra3xdh/TRX_RA3XDH_v2/BPF_6Band/BPF_6Band.kicad_pcb

## KiCad design BPF_6Band/BPF_6Band.kicad_pcb (2021-12-04)

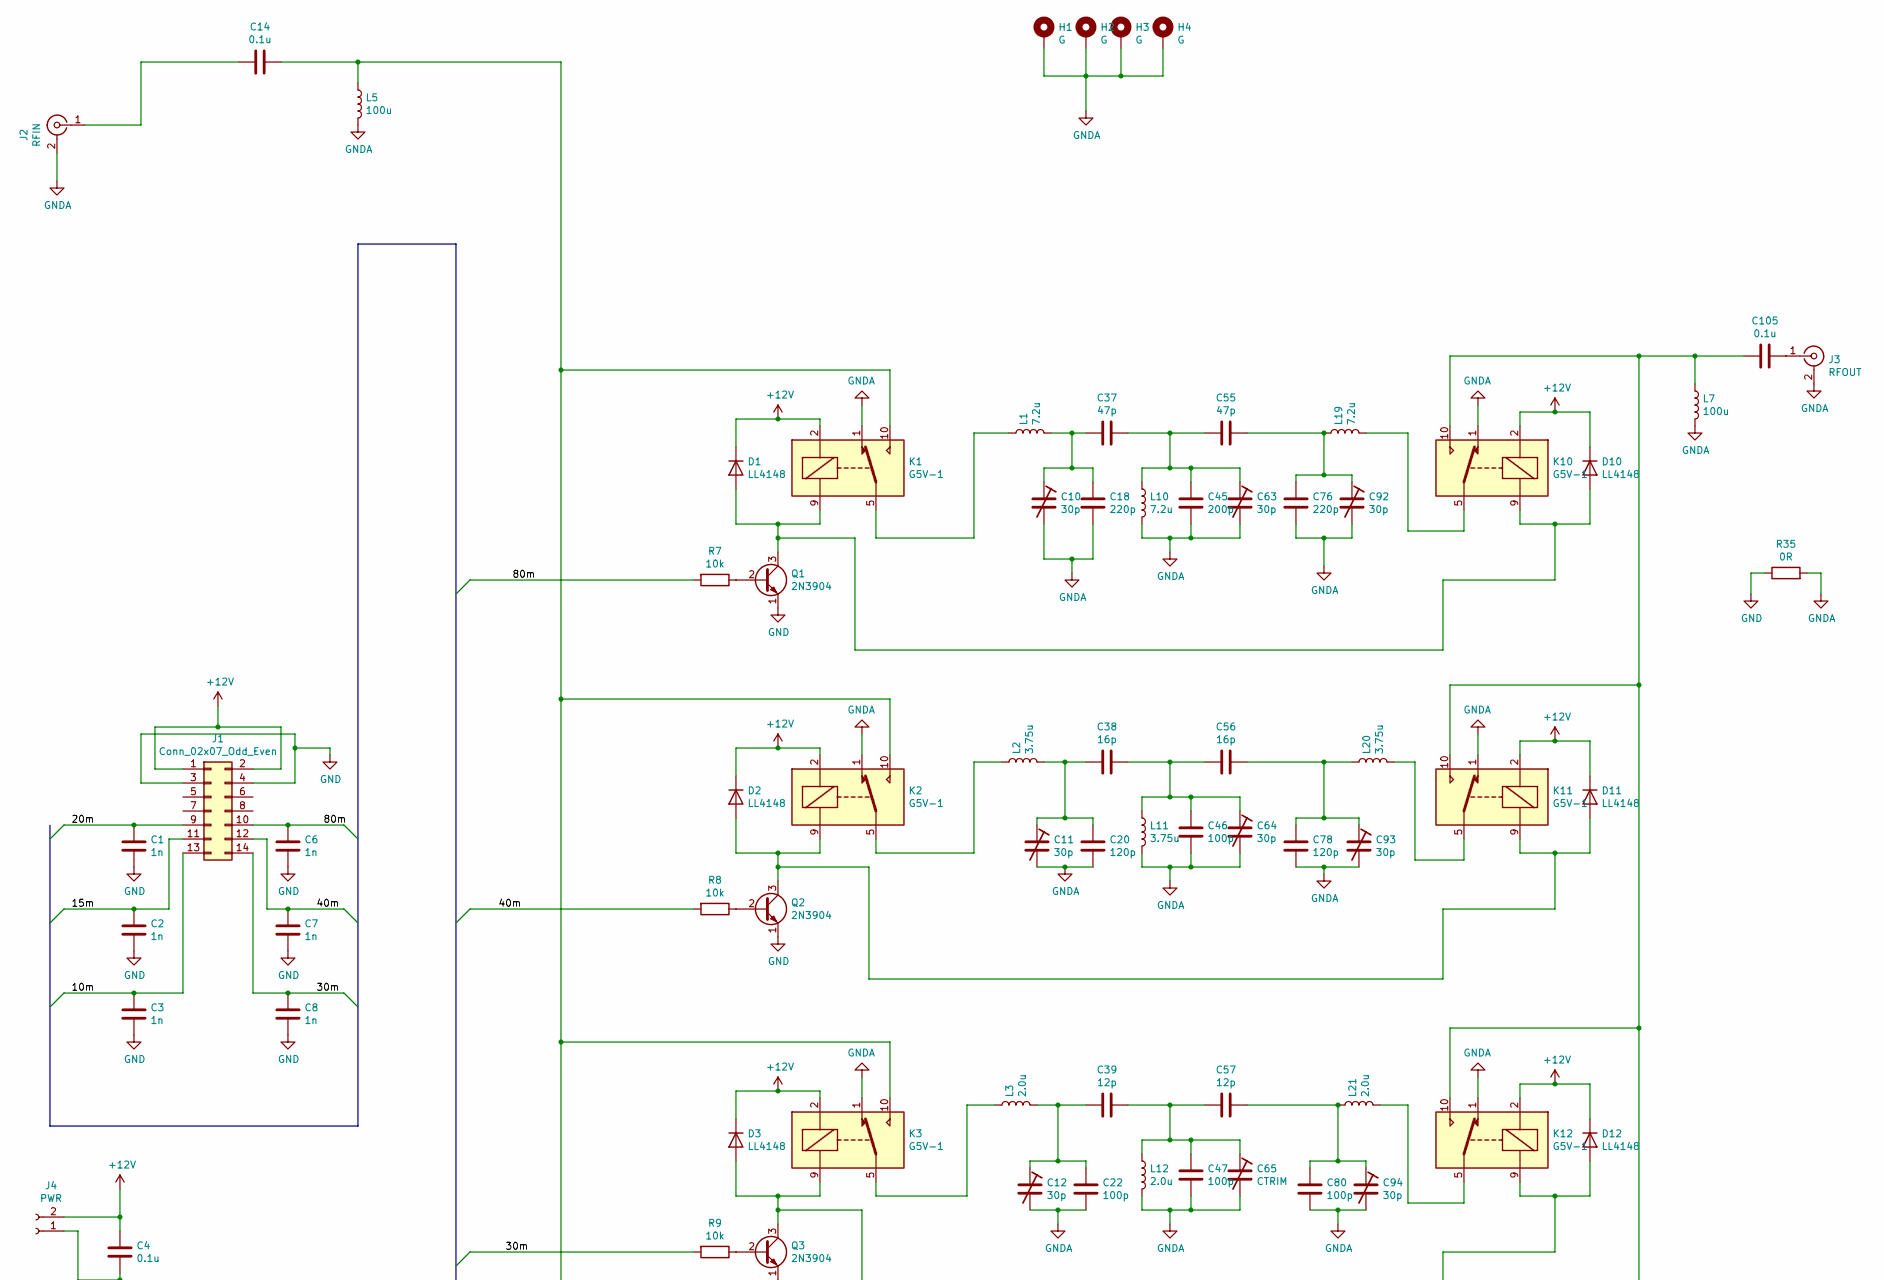
[picture p14: schematic BPF_6Band.sch, part in row 1, column 1]

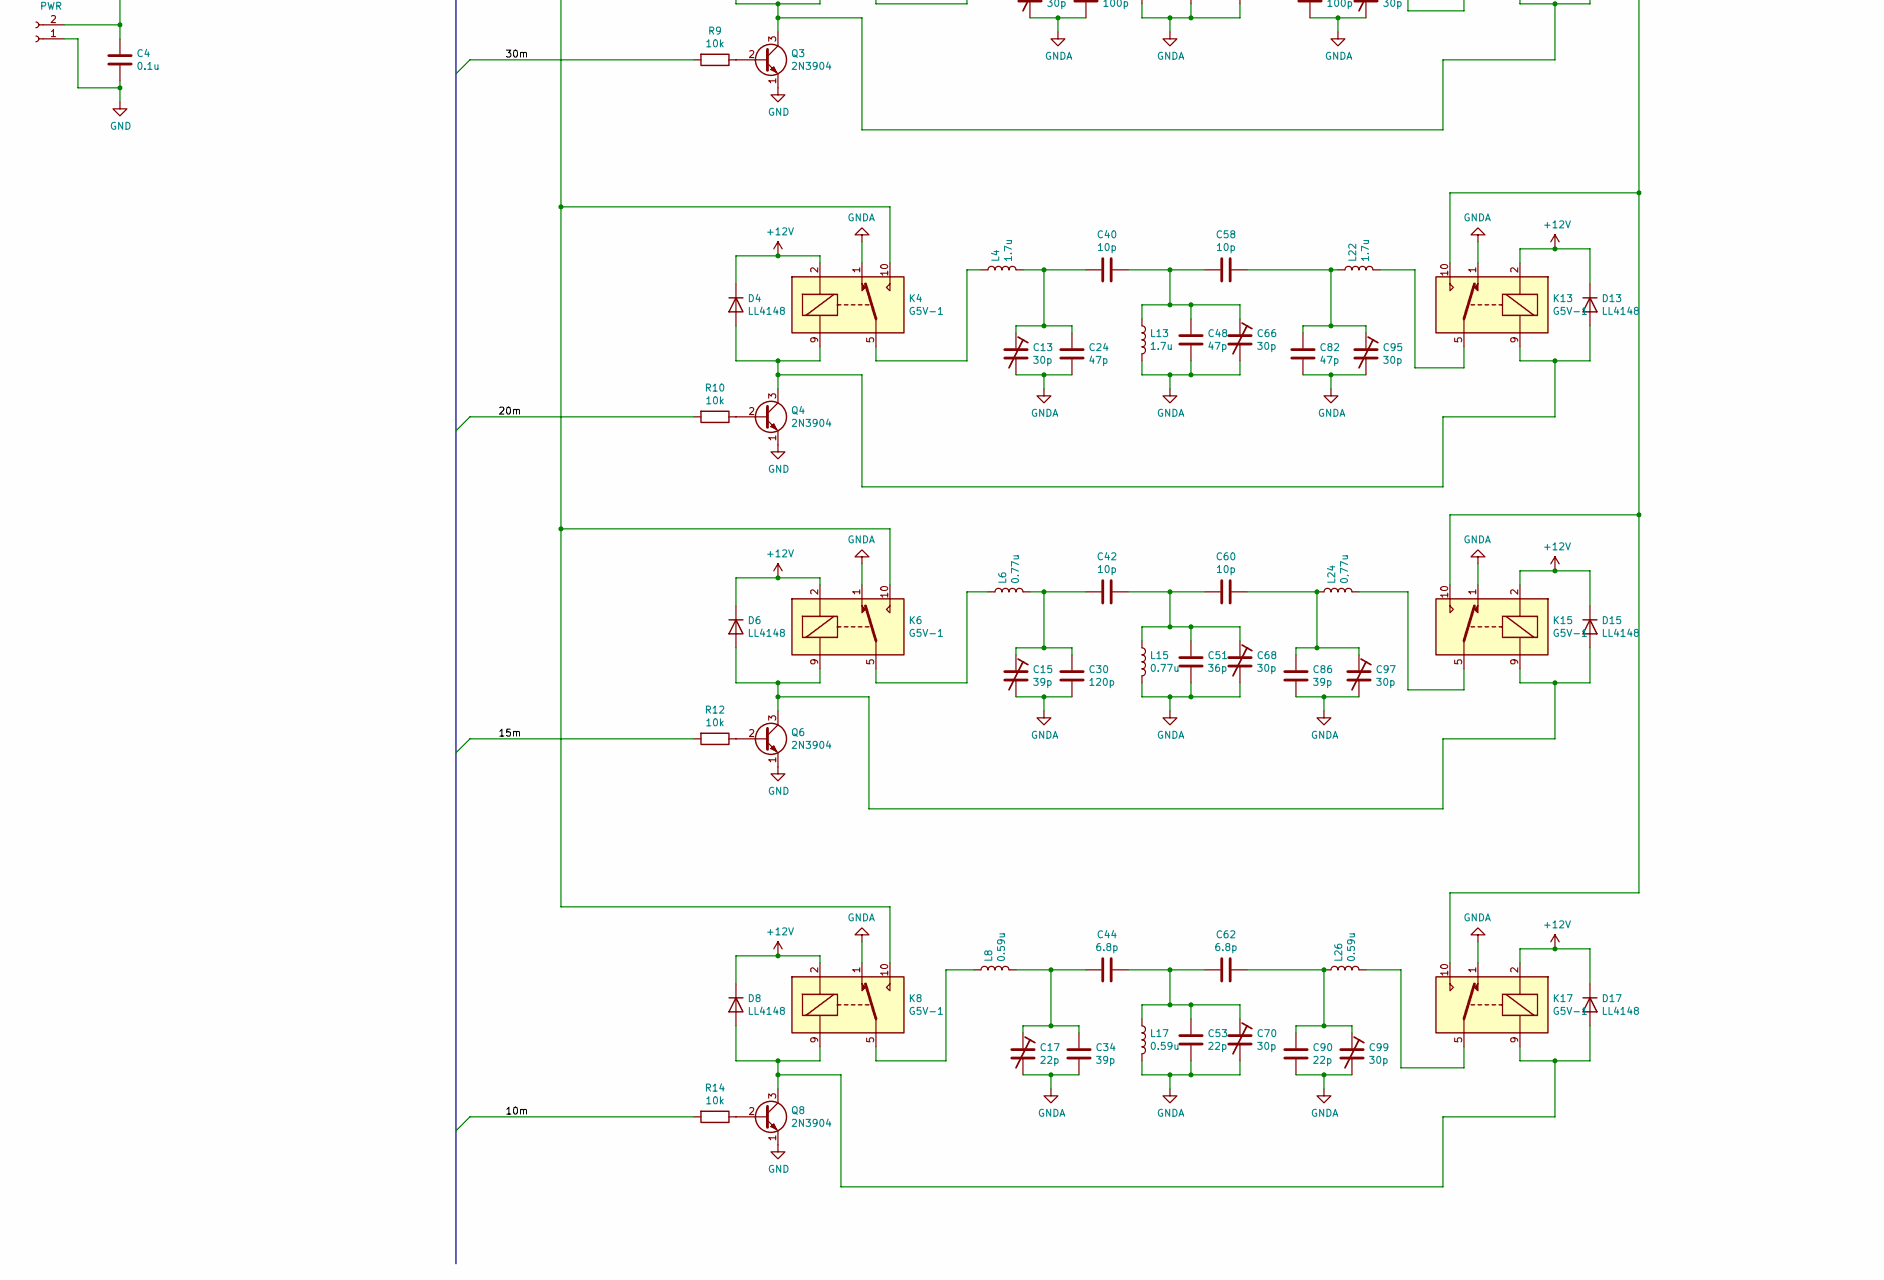
[picture p15: schematic BPF_6Band.sch, part in row 2, column 1]

Parts:
C1, C2, C3, C6, C7, C8: 1n; C_0805_2012Metric
C4, C14, C105: 0.1u; C_0805_2012Metric
C10, C11, C12, C13, C63, C64, C66, C68, C70, C92, C93, C94, C95, C97, C99: 30p; Ctrimm_5mm
C15: 39p; Ctrimm_5mm
C17: 22p; Ctrimm_5mm
C18, C76: 220p; C_0805_2012Metric
C20, C30, C78: 120p; C_0805_2012Metric
C22, C46, C47, C80: 100p; C_0805_2012Metric
C24, C37, C48, C55, C82: 47p; C_0805_2012Metric
C34, C86: 39p; C_0805_2012Metric
C38, C56: 16p; C_0805_2012Metric
C39, C57: 12p; C_0805_2012Metric
C40, C42, C58, C60: 10p; C_0805_2012Metric
C44, C62: 6.8p; C_0805_2012Metric
C45: 200p; C_0805_2012Metric
C51: 36p; C_0805_2012Metric
C53, C90: 22p; C_0805_2012Metric
C65: CTRIM; Ctrimm_5mm
D1, D2, D3, D4, D6, D8, D10, D11, D12, D13, D15, D17: LL4148; D_MiniMELF
H1, H2, H3, H4: G; MountingHole_3.2mm_M3_ISO7380_Pad
J1: Conn_02x07_Odd_Even; IDC-Header_2x07_P2.54mm_Vertical
J2: RFIN; SMA_Amphenol_132291_Vertical
J3: RFOUT; SMA_Amphenol_132291_Vertical
J4: PWR; JST_EH_B2B-EH-A_1x02_P2.50mm_Vertical
K1, K2, K3, K4, K6, K8, K10, K11, K12, K13, K15, K17: G5V-1; Relay_SPDT_Omron_G5V-1
L1, L10, L19: 7.2u; L_Toroid_Vertical_L10.0mm_W5.0mm_P5.08mm
L2, L11, L20: 3.75u; L_Toroid_Vertical_L10.0mm_W5.0mm_P5.08mm
L3, L12, L21: 2.0u; L_Toroid_Vertical_L10.0mm_W5.0mm_P5.08mm
L4, L13, L22: 1.7u; L_Toroid_Vertical_L10.0mm_W5.0mm_P5.08mm
L5, L7: 100u; L_Radial_D8.7mm_P5.00mm_Fastron_07HCP
L6, L15: 0.77u; L_Toroid_Vertical_L10.0mm_W5.0mm_P5.08mm
L8, L17, L26: 0.59u; L_Toroid_Vertical_L10.0mm_W5.0mm_P5.08mm
L24: 0,77u; L_Toroid_Vertical_L10.0mm_W5.0mm_P5.08mm
Q1, Q2, Q3, Q4, Q6, Q8: 2N3904; TO-92_Inline
R7, R8, R9, R10, R12, R14: 10k; R_0805_2012Metric
R35: 0R; R_0805_2012Metric

Connections:
+12V: C4.1, D1.1 (K), D2.1 (K), D3.1 (K), D4.1 (K), D6.1 (K), D8.1 (K), D10.1 (K), D11.1 (K), D12.1 (K), D13.1 (K), D15.1 (K), D17.1 (K), J1.1, J1.2, J4.2, K1.2, K2.2, K3.2, K4.2, K6.2, K8.2, K10.2, K11.2, K12.2, K13.2, K15.2, K17.2
/10m: C3.1, J1.13, R14.2
/15m: C2.1, J1.11, R12.2
/20m: C1.1, J1.9, R10.2
/30m: C8.1, J1.14, R9.2
/40m: C7.1, J1.12, R8.2
/80m: C6.1, J1.10, R7.2
GND: C1.2, C2.2, C3.2, C4.2, C6.2, C7.2, C8.2, J1.3, J1.4, J4.1, Q1.1 (E), Q2.1 (E), Q3.1 (E), Q4.1 (E), Q6.1 (E), Q8.1 (E), R35.1
GNDA: C10.2, C11.2, C12.2, C13.2, C15.2, C17.2, C18.2, C20.2, C22.2, C24.2, C30.2, C34.2, C45.2, C46.2, C47.2, C48.2, C51.2, C53.2, C63.2, C64.2, C65.2, C66.2, C68.2, C70.2, C76.2, C78.2, C80.2, C82.2, C86.2, C90.2, C92.2, C93.2, C94.2, C95.2, C97.2, C99.2, H1.1, H2.1, H3.1, H4.1, J2.2 (Ext), J3.2 (Ext), K1.1, K2.1, K3.1, K4.1, K6.1, K8.1, K10.1, K11.1, K12.1, K13.1, K15.1, K17.1, L5.2, L7.2, L10.2, L11.2, L12.2, L13.2, L15.2, L17.2, R35.2
unnamed: C10.1, C18.1, C37.2, L1.2
unnamed: C11.1, C20.1, C38.2, L2.2
unnamed: C12.1, C22.1, C39.2, L3.2
unnamed: C13.1, C24.1, C40.2, L4.2
unnamed: C14.1, K1.10, K2.10, K3.10, K4.10, K6.10, K8.10, L5.1
unnamed: C14.2, J2.1 (In)
unnamed: C15.1, C30.1, C42.2, L6.2
unnamed: C17.1, C34.1, C44.2, L8.2
unnamed: C37.1, C45.1, C55.2, C63.1, L10.1
unnamed: C38.1, C46.1, C56.2, C64.1, L11.1
unnamed: C39.1, C47.1, C57.2, C65.1, L12.1
unnamed: C40.1, C48.1, C58.2, C66.1, L13.1
unnamed: C42.1, C51.1, C60.2, C68.1, L15.1
unnamed: C44.1, C53.1, C62.2, C70.1, L17.1
unnamed: C55.1, C76.1, C92.1, L19.1
unnamed: C56.1, C78.1, C93.1, L20.1
unnamed: C57.1, C80.1, C94.1, L21.1
unnamed: C58.1, C82.1, C95.1, L22.1
unnamed: C60.1, C86.1, C97.1, L24.1
unnamed: C62.1, C90.1, C99.1, L26.1
unnamed: C105.1, J3.1 (In)
unnamed: C105.2, K10.10, K11.10, K12.10, K13.10, K15.10, K17.10, L7.1
unnamed: D1.2 (A), D10.2 (A), K1.9, K10.9, Q1.3 (C)
unnamed: D2.2 (A), D11.2 (A), K2.9, K11.9, Q2.3 (C)
unnamed: D3.2 (A), D12.2 (A), K3.9, K12.9, Q3.3 (C)
unnamed: D4.2 (A), D13.2 (A), K4.9, K13.9, Q4.3 (C)
unnamed: D6.2 (A), D15.2 (A), K6.9, K15.9, Q6.3 (C)
unnamed: D8.2 (A), D17.2 (A), K8.9, K17.9, Q8.3 (C)
unnamed: K1.5, K1.6, L1.1
unnamed: K2.5, K2.6, L2.1
unnamed: K3.5, K3.6, L3.1
unnamed: K4.5, K4.6, L4.1
unnamed: K6.5, K6.6, L6.1
unnamed: K8.5, K8.6, L8.1
unnamed: K10.5, K10.6, L19.2
unnamed: K11.5, K11.6, L20.2
unnamed: K12.5, K12.6, L21.2
unnamed: K13.5, K13.6, L22.2
unnamed: K15.5, K15.6, L24.2
unnamed: K17.5, K17.6, L26.2
unnamed: Q1.2 (B), R7.1
unnamed: Q2.2 (B), R8.1
unnamed: Q3.2 (B), R9.1
unnamed: Q4.2 (B), R10.1
unnamed: Q6.2 (B), R12.1
unnamed: Q8.2 (B), R14.1

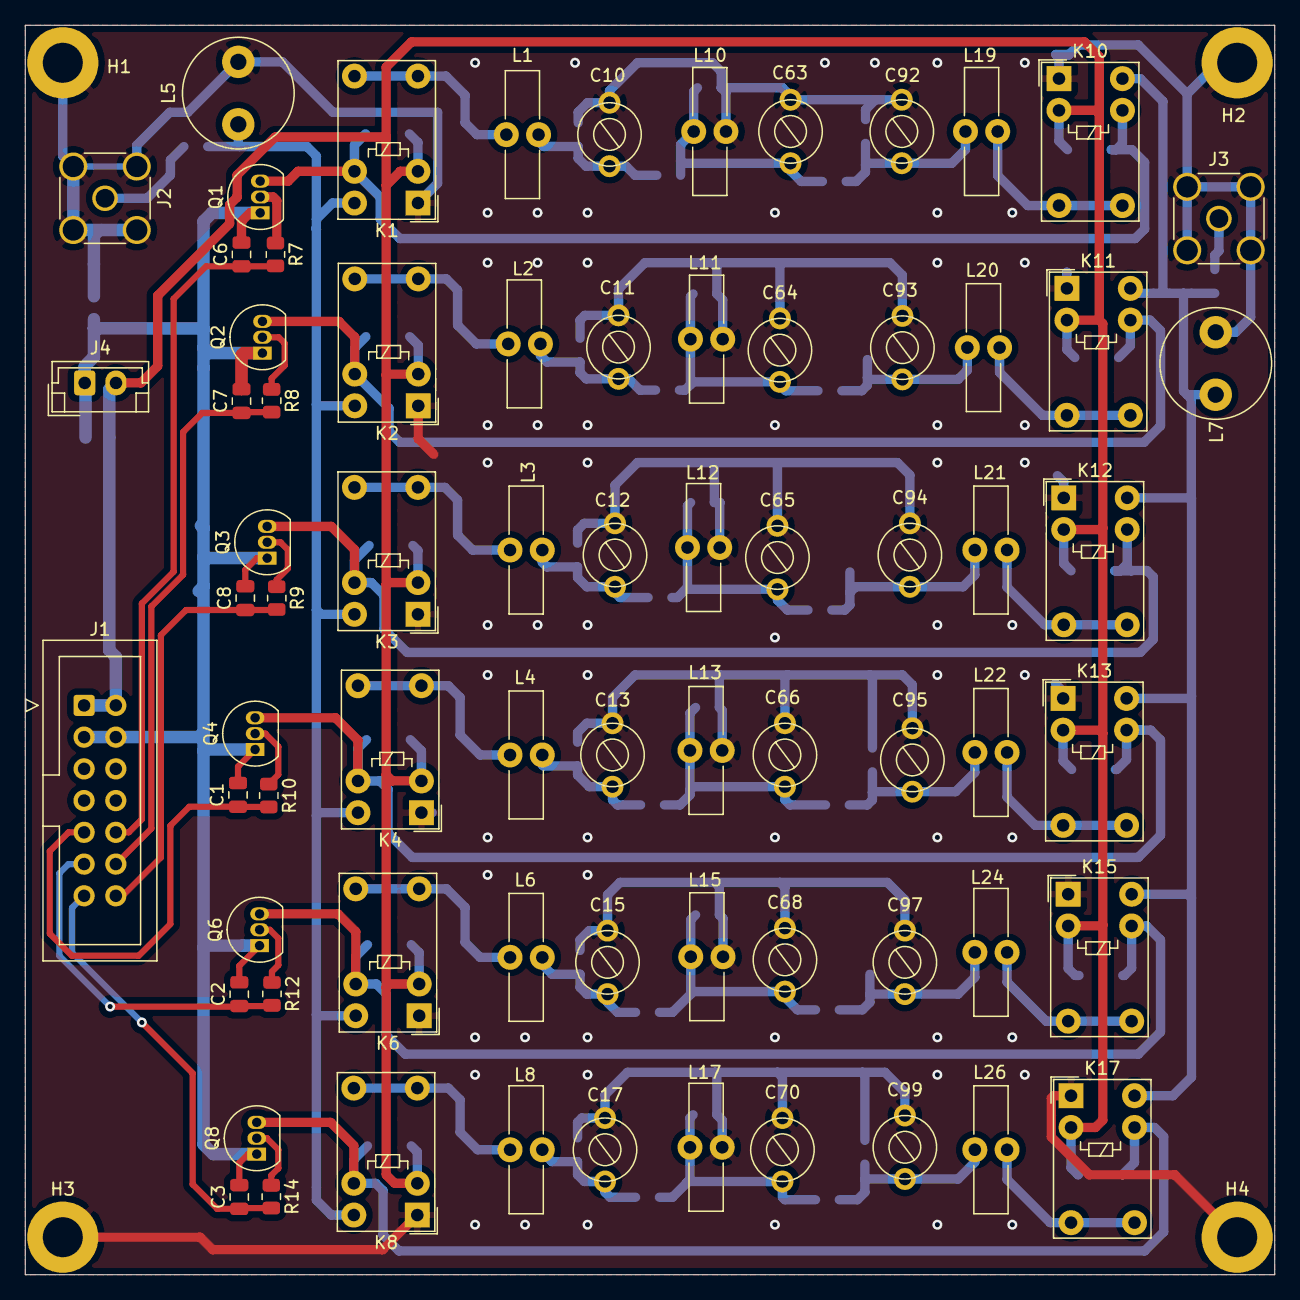
[picture p16: board BPF_6Band.kicad_pcb from above]

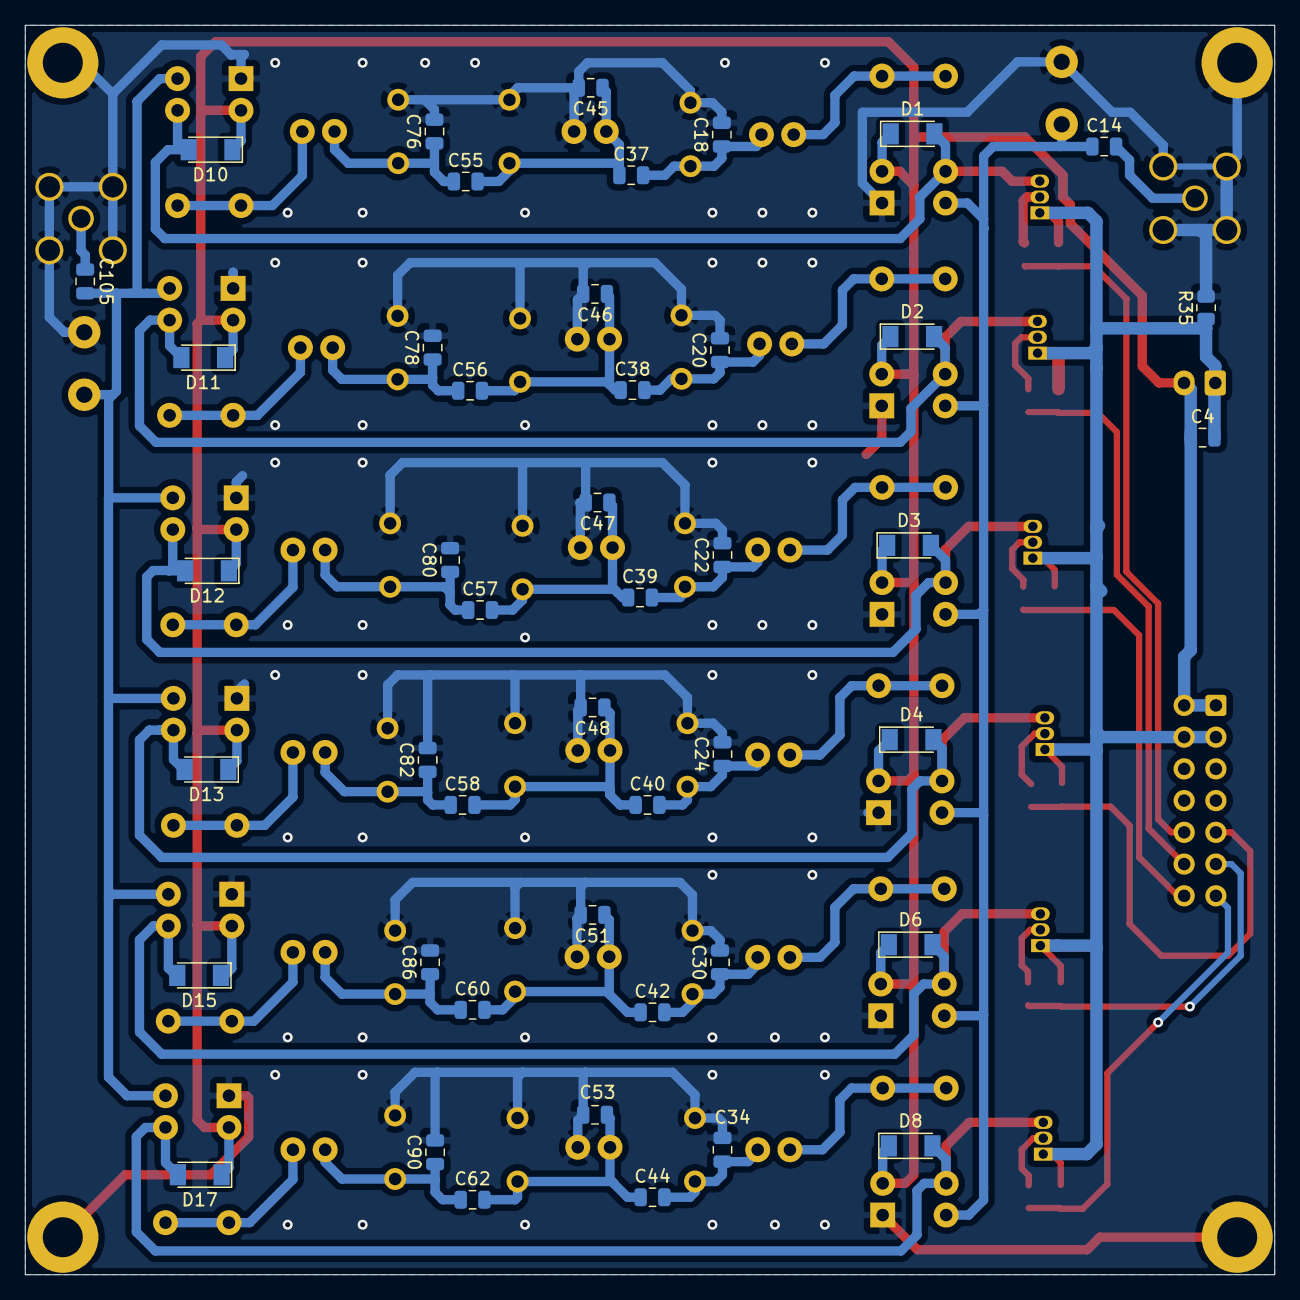
[picture p17: board BPF_6Band.kicad_pcb from below]

Board: 2 copper layers, 100.0 x 100.0 mm, 122 parts (46 on the bottom side), 55 nets.
