ra3xdh/TRX_RA3XDH_v2/ATMega64_AD9850/ATMega64_AD9850.kicad_pcb

## KiCad design ATMega64_AD9850/ATMega64_AD9850.kicad_pcb (2021-11-29)

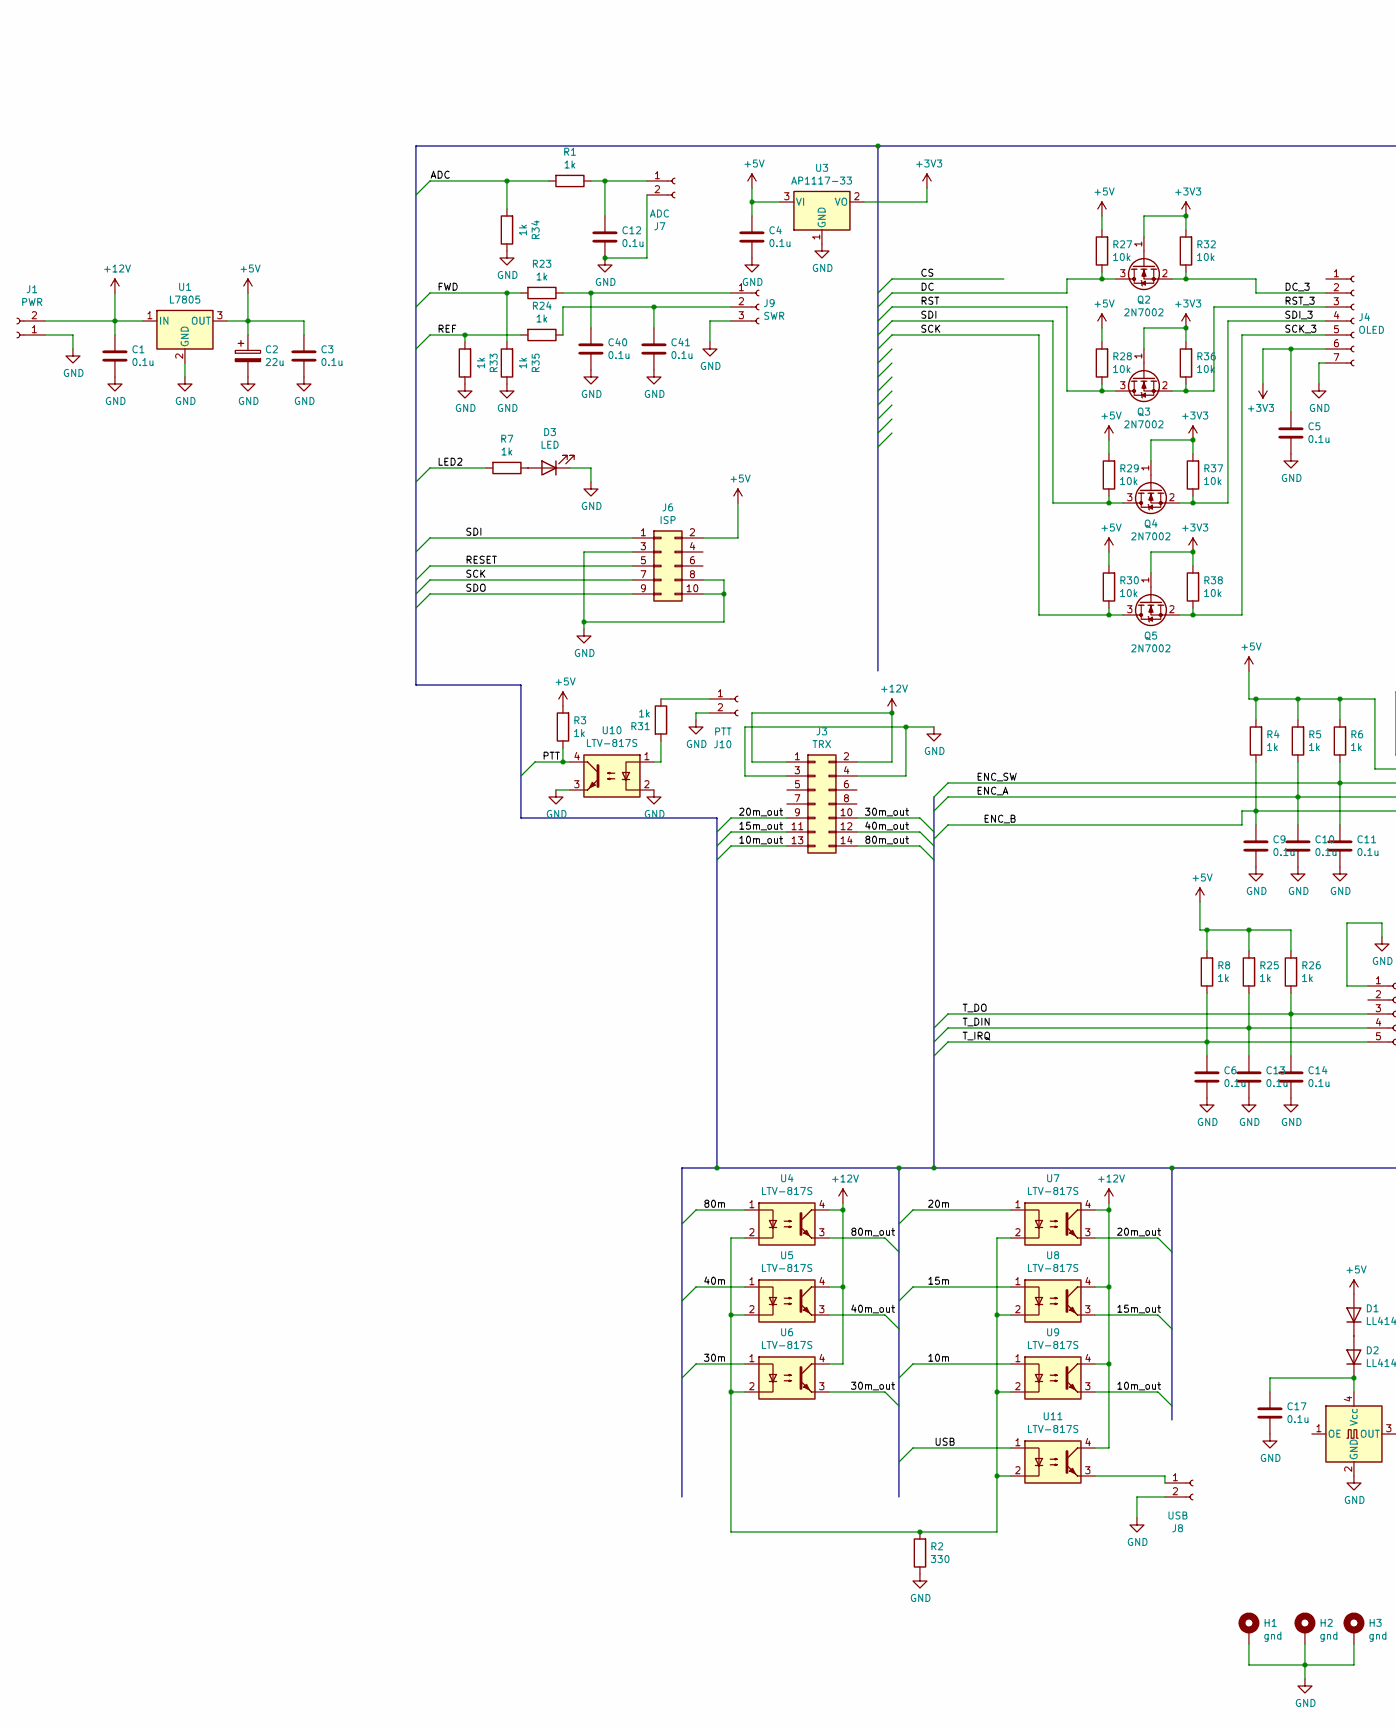
[picture p18: schematic ATMega64_AD9850.sch, part in row 1, column 1]

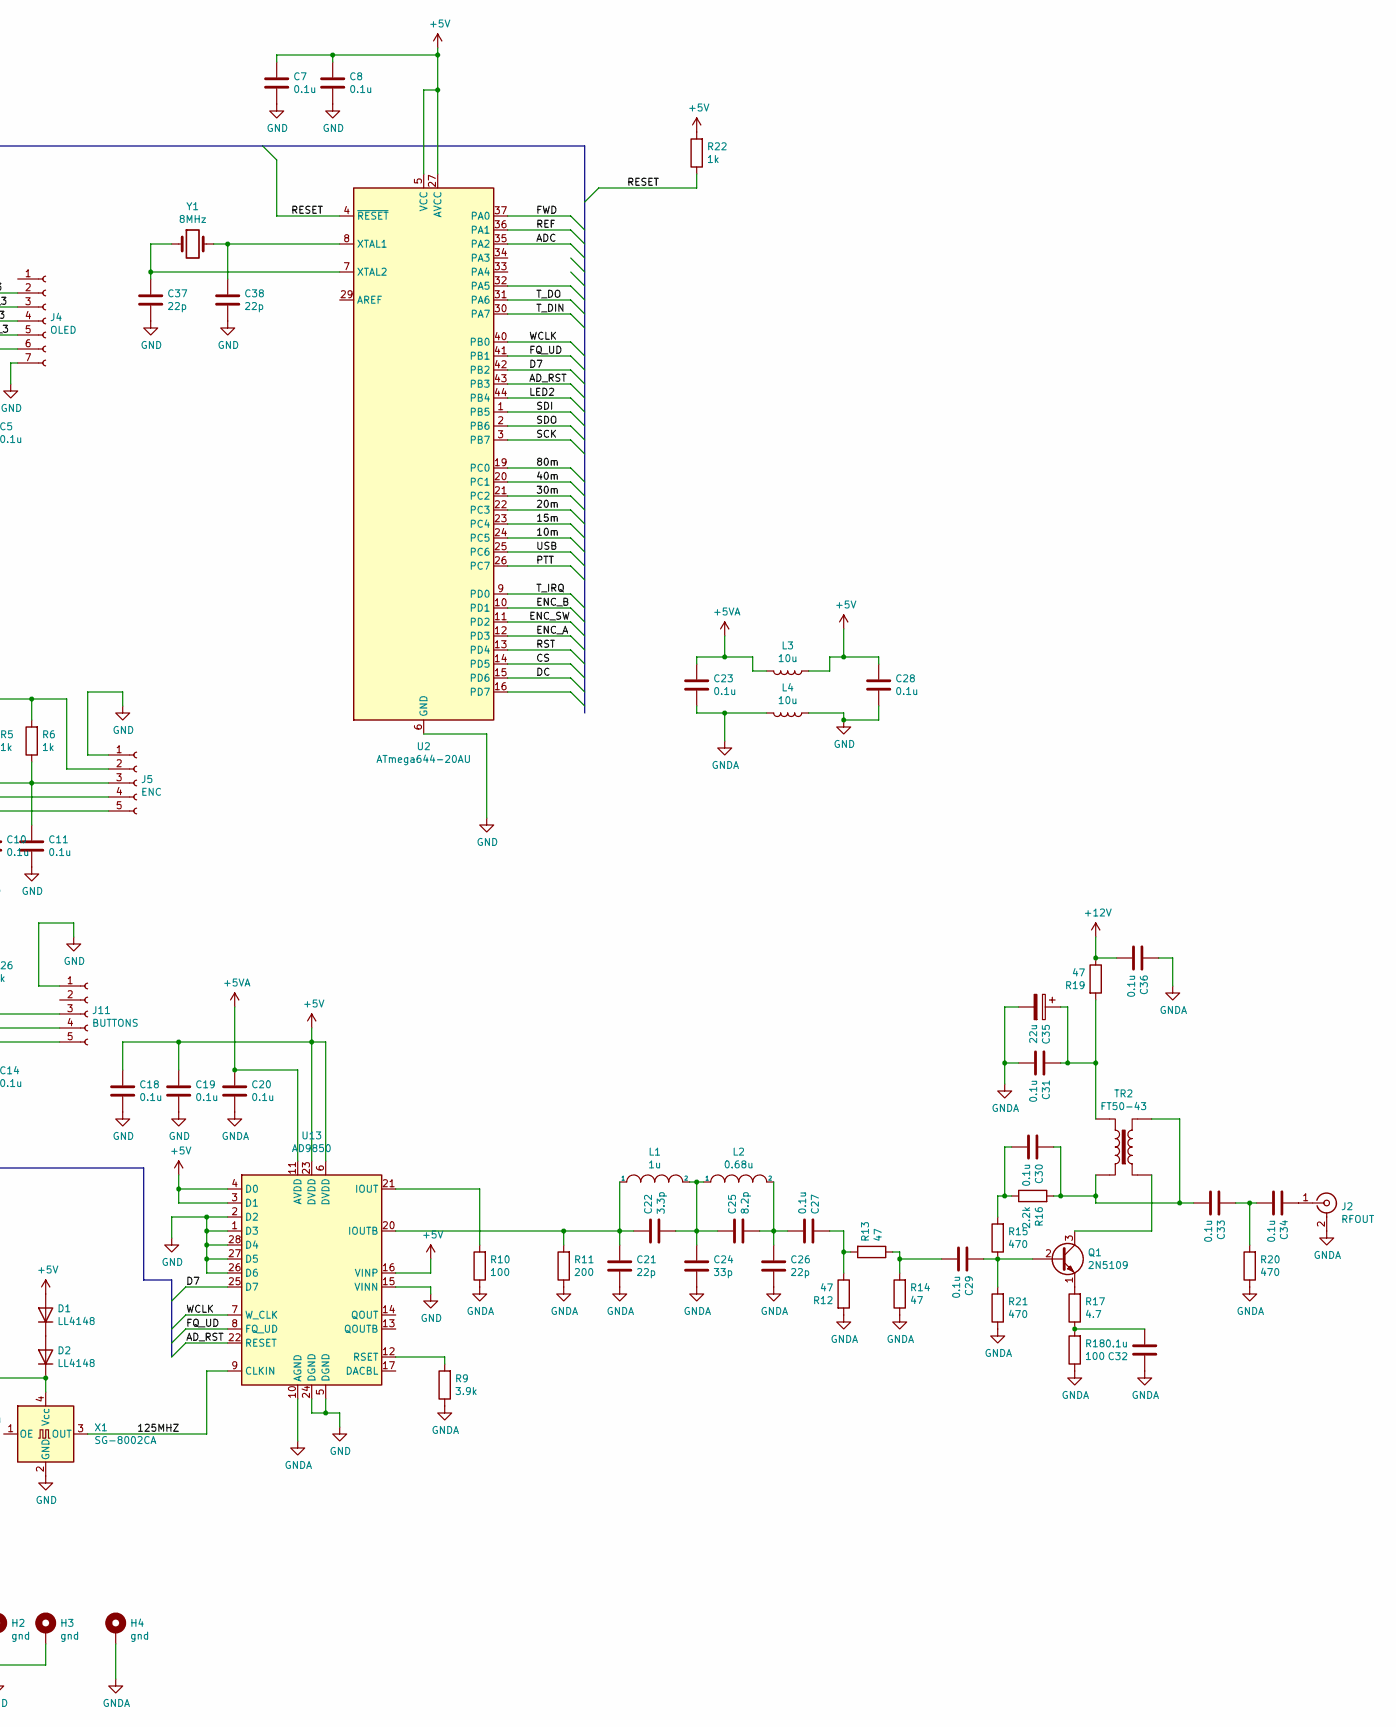
[picture p19: schematic ATMega64_AD9850.sch, part in row 1, column 2]

Parts:
C1, C3, C4, C5, C6, C7, C8, C9, C10, C11, C12, C13, C14, C17, C18, C19, C20, C23, C27, C28, C29, C30, C31, C32, C33, C34, C36, C40, C41: 0.1u; C_0805_2012Metric
C2, C35: 22u; CP_Radial_D5.0mm_P2.50mm
C21, C26, C37, C38: 22p; C_0805_2012Metric
C22: 3.3p; C_0805_2012Metric
C24: 33p; C_0805_2012Metric
C25: 8.2p; C_0805_2012Metric
D1, D2: LL4148; D_MiniMELF
D3: LED; LED_D3.0mm
H1, H2, H3, H4: gnd; MountingHole_3.2mm_M3_DIN965_Pad
J1: PWR; JST_EH_B2B-EH-A_1x02_P2.50mm_Vertical
J2: RFOUT; SMA_Amphenol_132291_Vertical
J3: TRX; IDC-Header_2x07_P2.54mm_Vertical
J4: OLED; PinHeader_1x07_P2.54mm_Vertical
J5: ENC; JST_EH_B5B-EH-A_1x05_P2.50mm_Vertical
J6: ISP; IDC-Header_2x05_P2.54mm_Vertical
J7: ADC; JST_EH_B2B-EH-A_1x02_P2.50mm_Vertical
J8: USB; JST_EH_B2B-EH-A_1x02_P2.50mm_Vertical
J9: SWR; JST_EH_B3B-EH-A_1x03_P2.50mm_Vertical
J10: PTT; JST_EH_B2B-EH-A_1x02_P2.50mm_Vertical
J11: BUTTONS; JST_EH_B5B-EH-A_1x05_P2.50mm_Vertical
L1: 1u; L_Toroid_Vertical_L10.0mm_W5.0mm_P5.08mm
L2: 0.68u; L_Toroid_Vertical_L10.0mm_W5.0mm_P5.08mm
L3, L4: 10u; L_Axial_L11.0mm_D4.5mm_P15.24mm_Horizontal_Fastron_MECC
Q1: 2N5109; TO-39-3
Q2, Q3, Q4, Q5: 2N7002; SOT-23
R1, R3, R4, R5, R6, R7, R8, R22, R23, R24, R25, R26, R31, R33, R34, R35: 1k; R_0805_2012Metric
R2: 330; R_0805_2012Metric
R9: 3.9k; R_0805_2012Metric
R10, R18: 100; R_0805_2012Metric
R11: 200; R_0805_2012Metric
R12, R13, R14, R19: 47; R_0805_2012Metric
R15, R20, R21: 470; R_0805_2012Metric
R16: 2.2k; R_0805_2012Metric
R17: 4.7; R_0805_2012Metric
R27, R28, R29, R30, R32, R36, R37, R38: 10k; R_0805_2012Metric
TR2: FT50-43; L_Toroid_Vertical_L10.0mm_W5.0mm_4pin
U1: L7805; TO-220-3_Vertical
U2: ATmega644-20AU; TQFP-44_10x10mm_P0.8mm
U3: AP1117-33; SOT-223-3_TabPin2
U4, U5, U6, U7, U8, U9, U10, U11: LTV-817S; SMDIP-4_W9.53mm
U13: AD9850; SSOP-28_5.3x10.2mm_P0.65mm
X1: SG-8002CA; Oscillator_SMD_SeikoEpson_SG8002CA-4Pin_7.0x5.0mm
Y1: 8MHz; Crystal_HC49-U_Vertical

Connections:
+3V3: C5.1, J4.6, Q2.1 (G), Q3.1 (G), Q4.1 (G), Q5.1 (G), R32.2, R36.2, R37.2, R38.2, U3.2 (VO)
+5V: C2.1, C3.1, C4.1, C7.1, C8.1, C18.1, C19.1, C28.1, D1.2 (A), J5.2, J6.2, L3.1, R3.2, R4.2, R5.2, R6.2, R8.2, R22.2, R25.2, R26.2, R27.2, R28.2, R29.2, R30.2, U1.3 (OUT), U2.5 (VCC), U2.17 (VCC), U2.27 (AVCC), U2.38 (VCC), U3.3 (VI), U13.3 (D1), U13.4 (D0), U13.6 (DVDD), U13.16 (VINP), U13.23 (DVDD)
+5VA: C20.1, C23.1, L3.2, U13.11 (AVDD), U13.18 (AVDD)
+12V: C1.1, C36.2, J1.2, J3.1, J3.2, R19.1, U1.1 (IN), U4.4, U5.4, U6.4, U7.4, U8.4, U9.4, U11.4
/10m: U2.24 (PC5), U9.1
/10m_out: J3.13, U9.3
/15m: U2.23 (PC4), U8.1
/15m_out: J3.11, U8.3
/20m: U2.22 (PC3), U7.1
/20m_out: J3.9, U7.3
/30m: U2.21 (PC2), U6.1
/30m_out: J3.10, U6.3
/40m: U2.20 (PC1), U5.1
/40m_out: J3.12, U5.3
/80m: U2.19 (PC0), U4.1
/80m_out: J3.14, U4.3
/125MHZ: U13.9 (CLKIN), X1.3 (OUT)
/ADC: R1.2, R34.2, U2.35 (PA2)
/AD_RST: U2.43 (PB3), U13.22 (RESET)
/D7: U2.42 (PB2), U13.25 (D7)
/DC: Q2.3 (D), R27.1, U2.15 (PD6)
/DC_3: J4.2, Q2.2 (S), R32.1
/ENC_A: C10.1, J5.4, R5.1, U2.12 (PD3)
/ENC_B: C9.1, J5.5, R4.1, U2.10 (PD1)
/ENC_SW: C11.1, J5.3, R6.1, U2.11 (PD2)
/FQ_UD: U2.41 (PB1), U13.8 (FQ_UD)
/FWD: R23.2, R35.2, U2.37 (PA0)
/LED2: R7.2, U2.44 (PB4)
/PTT: R3.1, U2.26 (PC7), U10.4
/REF: R24.2, R33.2, U2.36 (PA1)
/RESET: J6.5, R22.1, U2.4 (~RESET)
/RST: Q3.3 (D), R28.1, U2.13 (PD4)
/RST_3: J4.3, Q3.2 (S), R36.1
/SCK: J6.7, Q5.3 (D), R30.1, U2.3 (PB7)
/SCK_3: J4.5, Q5.2 (S), R38.1
/SDI: J6.1, Q4.3 (D), R29.1, U2.1 (PB5)
/SDI_3: J4.4, Q4.2 (S), R37.1
/SDO: J6.9, U2.2 (PB6)
/T_DIN: C13.1, J11.4, R25.1, U2.30 (PA7)
/T_DO: C14.1, J11.3, R26.1, U2.31 (PA6)
/T_IRQ: C6.1, J11.5, R8.1, U2.9 (PD0)
/USB: U2.25 (PC6), U11.1
/WCLK: U2.40 (PB0), U13.7 (W_CLK)
GND: C1.2, C2.2, C3.2, C4.2, C5.2, C6.2, C7.2, C8.2, C9.2, C10.2, C11.2, C12.2, C13.2, C14.2, C17.2, C18.2, C19.2, C28.2, C37.2, C38.2, C40.2, C41.2, D3.1 (K), H1.1, H2.1, H3.1, J1.1, J3.3, J3.4, J4.7, J5.1, J6.3, J6.8, J6.10, J7.2, J8.2, J9.3, J10.2, J11.1, L4.1, R2.1, R33.1, R34.1, R35.1, U1.2 (GND), U2.6 (GND), U2.18 (GND), U2.28 (GND), U2.39 (GND), U3.1 (GND), U10.2, U10.3, U13.1 (D3), U13.2 (D2), U13.5 (DGND), U13.15 (VINN), U13.24 (DGND), U13.26 (D6), U13.27 (D5), U13.28 (D4), X1.2 (GND)
GNDA: C20.2, C21.2, C23.2, C24.2, C26.2, C31.2, C32.1, C35.2, C36.1, H4.1, J2.2 (Ext), L4.2, R9.1, R10.1, R11.1, R12.2, R14.1, R18.1, R20.1, R21.1, U13.10 (AGND), U13.19 (AGND)
unnamed: C12.1, J7.1, R1.1
unnamed: C17.1, D2.1 (K), X1.4 (Vcc)
unnamed: C21.1, C22.1, L1.1, R11.2, U13.20 (IOUTB)
unnamed: C22.2, C24.1, C25.1, L1.2, L2.1
unnamed: C25.2, C26.1, C27.2, L2.2
unnamed: C27.1, R12.1, R13.2
unnamed: C29.1, Q1.2 (B), R15.1, R21.2
unnamed: C29.2, R13.1, R14.2
unnamed: C30.1, C33.2, R16.2, TR2.2, TR2.4
unnamed: C30.2, R15.2, R16.1
unnamed: C31.1, C35.1, R19.2, TR2.3
unnamed: C32.2, R17.1, R18.2
unnamed: C33.1, C34.2, R20.2
unnamed: C34.1, J2.1 (In)
unnamed: C37.1, U2.7 (XTAL2), Y1.1
unnamed: C38.1, U2.8 (XTAL1), Y1.2
unnamed: C40.1, J9.1, R23.1
unnamed: C41.1, J9.2, R24.1
unnamed: D1.1 (K), D2.2 (A)
unnamed: D3.2 (A), R7.1
unnamed: J8.1, U11.3
unnamed: J10.1, R31.1
unnamed: Q1.1 (E), R17.2
unnamed: Q1.3 (C), TR2.1
unnamed: R2.2, U4.2, U5.2, U6.2, U7.2, U8.2, U9.2, U11.2
unnamed: R9.2, U13.12 (RSET)
unnamed: R10.2, U13.21 (IOUT)
unnamed: R31.2, U10.1

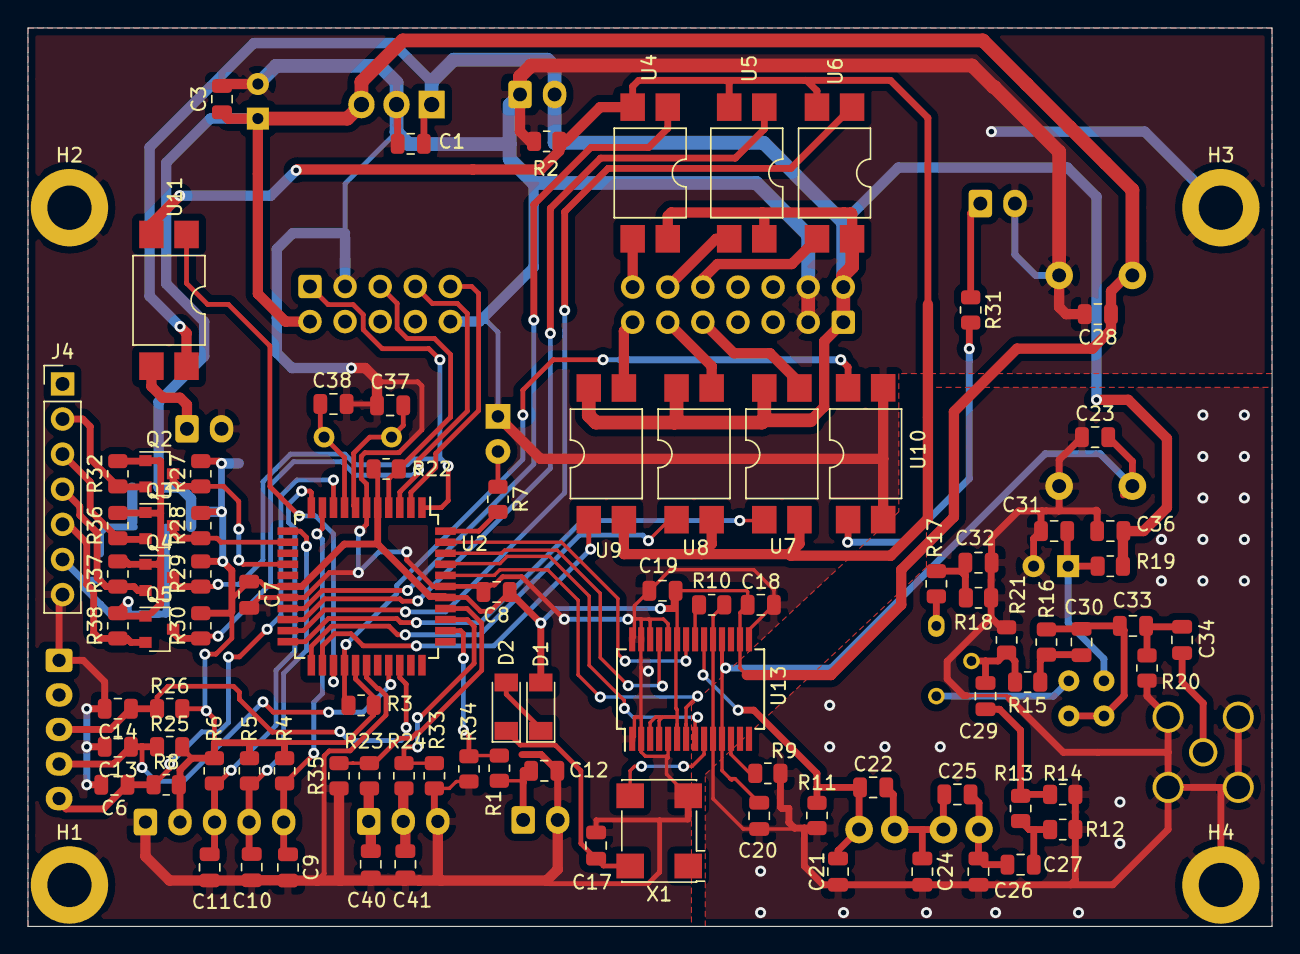
[picture p20: board ATMega64_AD9850.kicad_pcb from above]

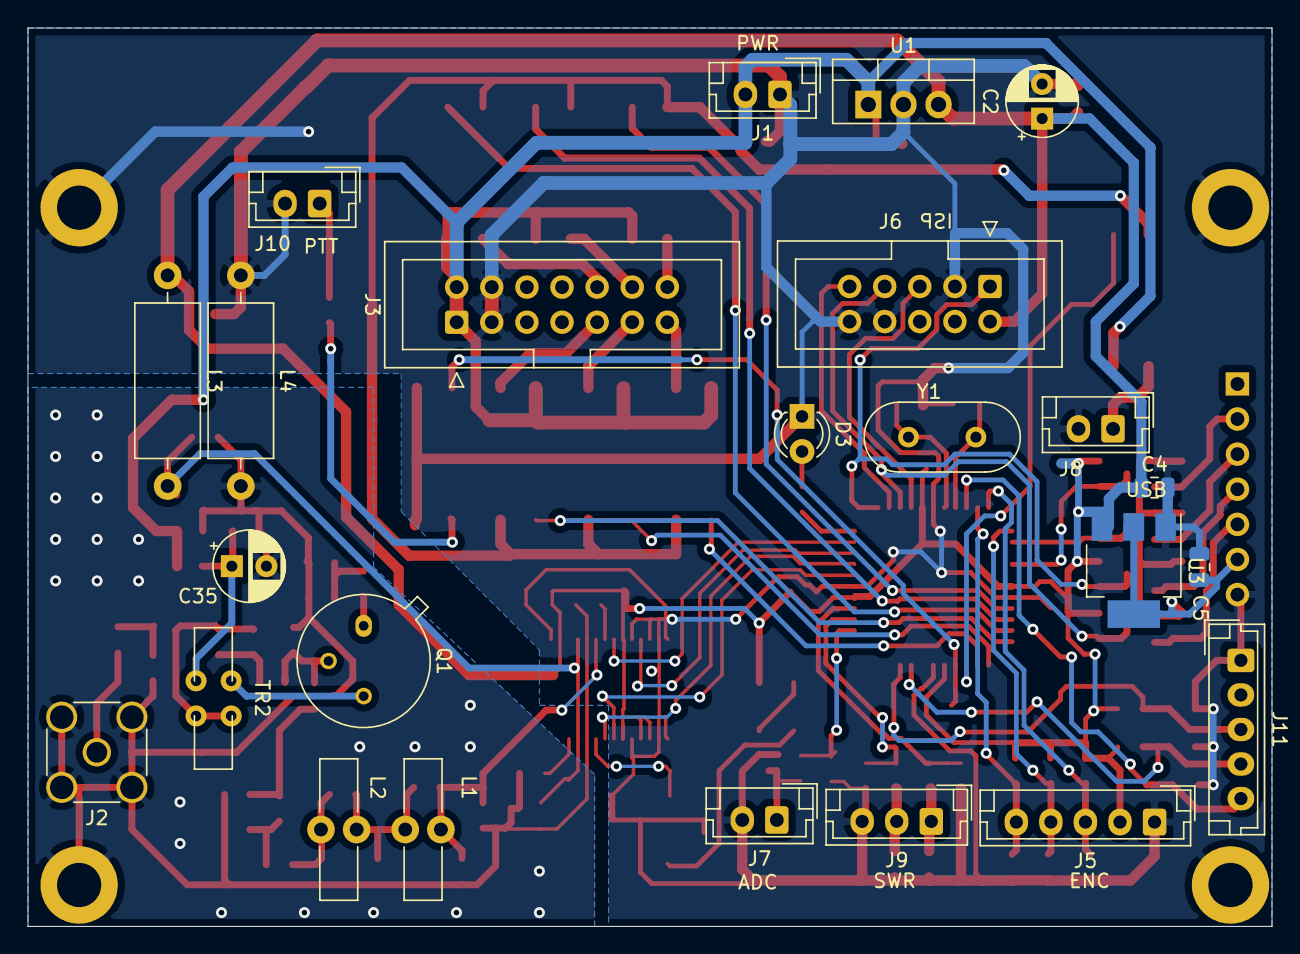
[picture p21: board ATMega64_AD9850.kicad_pcb from below]

Board: 2 copper layers, 90.0 x 65.0 mm, 118 parts (24 on the bottom side), 73 nets.
