ra3xdh/TRX_RA3XDH_v2/(commit log)

2021-11-29 Mainboard is opearational, assembled and tested
    [TRX_RA3XDH.kicad_pcb, TRX_RA3XDH.sch]
2021-11-29 Added AD9850 syntesizer
    [ATMega64_AD9850.kicad_pcb, ATMega64_AD9850.sch]
2021-12-04 Fixed BFO schematic
    [TRX_RA3XDH.sch]
2021-12-04 Add 6-Band band N7DDC pass filter
    [BPF_6Band-B_Cu.gbl, BPF_6Band-B_Mask.gbs, BPF_6Band-B_SilkS.gbo, BPF_6Band-Edge_Cuts.gm1, BPF_6Band-F_Cu.gtl, BPF_6Band-F_Mask.gts, BPF_6Band-F_SilkS.gto, BPF_6Band.drl]
2021-12-04 Added PA bypass and RF preamp boards
    [ATT_2N5109_AMP.kicad_pcb, ATT_2N5109_AMP.sch, PA_comm.kicad_pcb, PA_comm.sch]
2021-12-04 Add PNG schematics
